ctrlvlts-000/Vintage-Sound-Chip-Player/README.md

# YM2612 Player

A desktop box where a real Yamaha YM2612 sound chip, lit behind a glass window, plays your own music files while you reach into its registers.

See [docs/DESIGN.md](docs/DESIGN.md) for the design.
