ctrlvlts-000/Vintage-Sound-Chip-Player/hardware/README.md

# YM2612 player hardware (Rev B)

The Rev B board, drawn in KiCad. It follows [docs/DESIGN.md](../docs/DESIGN.md). The goal is a
**PCBWay turnkey prototype**: PCBWay makes the board, buys the parts and solders them on. Joey supplies
the YM2612 and plugs it into the socket.

**Status:** Rev B, the Rev A circuit and part positions re-routed after the Oct 30 peer review (see "Rev B changes").
Checked in KiCad 7 in the cloud: DRC 0 errors, 0 unconnected pads and 0 silkscreen warnings. ERC and a final DRC
still need running in KiCad 10. Not ordered yet: see "Still to do before ordering".

## Rev B changes (peer review, Oct 30)

Same circuit, same part positions (the case and 3D model still fit). What changed on the board:

| Review point | Rev A | Rev B |
| --- | --- | --- |
| Clearances | 0.20 mm tracks and gaps, routed right at the limit; vias 0.6 / 0.3 mm (0.15 mm ring, PCBWay's minimum) | 0.25 mm tracks and gaps; vias 0.7 / 0.3 mm (0.2 mm ring). Only the headphone amp's own 0.5 mm-pitch pins keep 0.2 mm (`HP_amp` net class and `ym2612_player.kicad_dru`) |
| Ground traces | 271 ground track pieces, 917 mm, mostly on top of the ground plane | Ground left to the planes. 20 short pieces (49 mm in all) remain where a pad needs one: chip pins onto U8's exposed pad, and pads in small pieces of plane joined to a via |
| Right angles | 66 corners at 90 degrees, 1 sharper | none in open track (43 cut into two 45 degree bends by `tools/miter.py`); the few left sit inside a pad or via |
| Silkscreen | 0.8 mm labels, 95 DRC warnings, 40 labels on a neighbouring part | 1.0 mm labels with a 0.15 mm stroke, none on a pad, part, other label or edge. 24 labels with no clear spot moved to the assembly (F.Fab) layer. Outlines trimmed where stock footprints drew them through pads (the 12 mm buttons). The Gerbers also cut silkscreen away from every pad |
| Logo | none | `[-] CTRLVLTS [+]` on the front silkscreen, above the buttons |
| Pad sizes | KiCad's standard footprints, IPC-7351B nominal | unchanged: these already include the IPC solder fillet margins |

**Just want to look?** Open [ym2612_player/ym2612_player.pdf](ym2612_player/ym2612_player.pdf). GitHub shows it in the browser.
The parts list is [ym2612_player/bom.csv](ym2612_player/bom.csv).
The board, seen from the top:

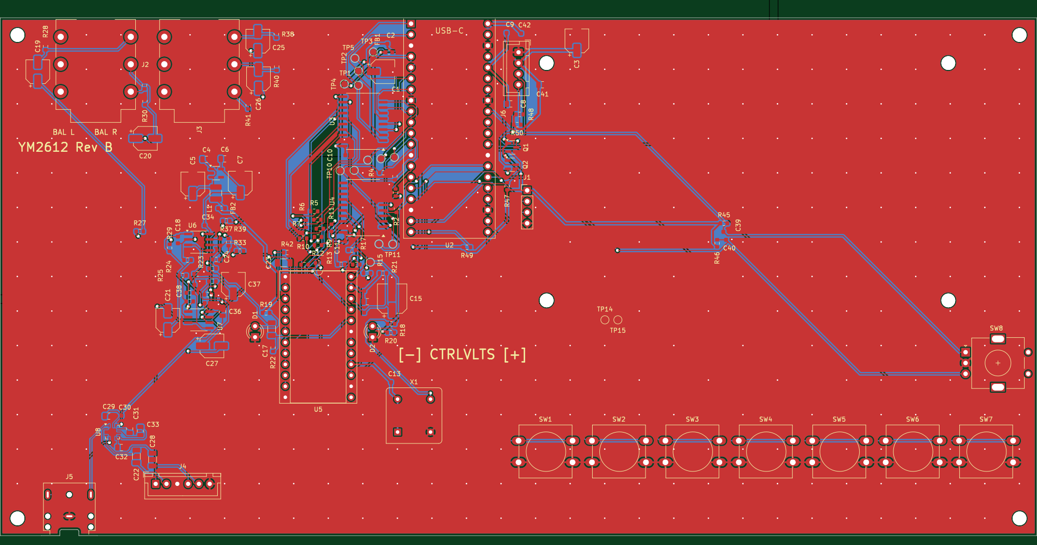
[picture p1: hardware/ym2612_player/board_top.png]
Rev B board, top view


## Opening it in KiCad

1. Install KiCad (any version from 7 up) from <https://www.kicad.org/download/>.
2. Download this repository: on GitHub click the green **Code** button, then **Download ZIP**, and unzip it.
   (While this is still a pull request, pick its branch in the branch menu at the top left first.)
3. In KiCad choose **File > Open Project** and pick `hardware/ym2612_player/ym2612_player.kicad_pro`.
4. Double-click **ym2612_player.kicad_sch**. The first page has one box per page; double-click a box to go in,
   **Alt + Backspace** to come back out.

The files are saved in KiCad 7 format. Newer KiCad opens them and offers to upgrade them the first time you save.
If you'd rather keep working in your own **YM2612 player** project, copy these files into it, or ask Claude to do it
through folder access.

**Reading the drawing:** green lines are wires, drawn part to part (Rev B; Rev A used name tags only). A signal that
goes to another page ends in a name tag (label): tags with the same name are connected, even on different pages. A
small name on a wire is just that wire's name. `+5V`, `+5V_YM`, `+4V5A`, `+3V3` and `GND` are power connections. A
blue X means "not connected on purpose". A part crossed out in red is "do not fit": it has a footprint but PCBWay
leaves it off. The test points on the Controller page still connect by name, like probes.

## Pages

| Page | What's on it |
| --- | --- |
| Power | 5V from the Pico's USB-C, a ferrite-filtered 5V for the chip, and a quiet 4.5V LDO rail for the audio |
| Controller | Pimoroni Pico Plus 2 on two 20-pin sockets, boot-time pull resistors, spare-pin header, test points |
| Sound chip | YM2612 socket, two 74HCT541 buffers (3.3V to 5V) with 100 ohm resistors, clock options, window LEDs |
| Audio out | Model 1 style filter, balanced 1/4" outs, headphone amp with the dual slide volume |
| Front panel | 7 buttons (12 mm), data knob, I2C level shifter, LCD connector |

## The board

240 x 120 mm, 2 layers, rear edge at the top of the picture. Positions below are part centres, measured in mm from
the board's rear-left corner (x to the right, y towards the front). They are what the case needs.

| What | Where |
| --- | --- |
| M3 mounting holes | (4, 4), (236, 4), (4, 116), (236, 116) |
| M3 holes for the LCD standoffs | (126.5, 10.5), (219.5, 10.5), (126.5, 65.5), (219.5, 65.5) |
| Balanced 1/4" outs L / R (rear) | x 30.3 and 54.3, on the rear edge |
| Pico Plus 2 USB-C (rear) | x 104, on the rear edge |
| 3.5 mm headphone jack (front) | x 16, on the front edge |
| Volume slider plug (6-pin JST XH) | (36, 108); the slider itself sits in the case top |
| YM2612 socket / round chip window | window centre (73.6, 74), 44 mm across |
| LCD module (98 x 60 mm, on 15 mm standoffs) | from (124, 8) to (222, 68); its connector J6 just left of it, at about (120, 12) |
| 7 buttons, 12 mm | one row at y 98, from x 120 (Play) to x 222 (Write), 17 mm apart |
| Data knob (encoder) | shaft at (231, 80), below the LCD so the knob clears it |

Ground: one unbroken `GND` plane on both layers, tied together by stitching vias. The audio parts are grouped on the
left, away from USB, the bus and the LCD. (Rev A's first layout split the ground, which put the YM2612's bus over the
audio ground; see the fix register.)

## Ordering from PCBWay (turnkey)

Everything PCBWay asks for is in [ym2612_player/fab](ym2612_player/fab):

- `ym2612_player_gerbers.zip`: the board itself (copper, solder mask, silkscreen, outline, drill holes).
- `ym2612_player_bom.csv`: the parts list. Lines marked "Do not fit" are left off on purpose.
- `ym2612_player_cpl.csv`: where each part goes and which way it turns (the "placement" or "centroid" file).

Upload the zip on PCBWay's PCB Assembly page, choose Turnkey, then add the BOM and CPL when it asks. They check every
part before anything is made and email questions. Nothing is charged until you approve their quote.

## Choices made in this draft

- **Pico Plus 2 on sockets** (Digi-Key PIM724). It has chips and a connector on its underside, so it can't be soldered
  flat. PCBWay solders two 1x20 female sockets to the board (BOM line `U2-SKT`, Sullins PPTC201LFBN-RC, 8.5 mm).
  **Joey supplies the Pico and its two 1x20 male headers** (`U2`, `U2-HDR`, marked "Do not fit"), solders the headers
  and plugs it in, about 9 mm above the board (Joey, Oct 25).
- **YM2612 socket:** Mill-Max turned-pin, 24-pin, 600 mil wide. PCBWay solders the socket only.
- **Clock:** the Pico makes the 7.67 MHz clock (as the design doc proposes). There's an unfitted footprint for a
  7.670454 MHz oscillator can, so switching to exact Genesis pitch is a two-part change with no new board.
- **Buttons:** 12 mm Omron B3F-4055 switches with snap-on round caps (your choice, Oct 24).
- **Analog rail:** LP5907 4.5V low-noise regulator after a ferrite and an LC filter, damped by a 47 µF electrolytic.
- **YM2612 analog supply:** its A.VCC pin (22) has its own 10 ohm + 220 µF + 100 nF filter, so USB noise on the
  chip's 5V doesn't reach its DAC.
- **Decoupling:** every chip has its capacitors within a few mm of its supply pin.
- **Reset pull-downs:** 4.7k on /IC, A0 and A1, because of RP2350 erratum E9 (10k may not pull a released pin low).
- **Ground:** one solid plane, see above.
- **Audio filter:** 2.2k load, then a 3.39 kHz first-order low-pass (Model 1 style). See DESIGN.md 5.5.
- **Balanced outs:** hot and cold legs from OPA2350s, 100 ohm + 10 µF each, Neutrik NMJ6HCD2 jacks, with a 0 ohm
  ground-lift footprint on each sleeve.
- **Headphones:** TI TPA6132A2 headphone amp on the 4.5V rail, -6 dB gain, no output capacitors (Joey, Oct 25). The
  Pico's GP12 switches it on once the rail has settled, so power-up doesn't pop. Firmware must set GP12 high.

## Still to do before ordering

1. **Case:** Joey designs the enclosure around the positions above (Oct 25). Check heights too: the LCD glass sits
   about 27 to 30 mm up, the buttons with caps about 13 mm, the knob shaft about 20 mm.
2. **KiCad 10:** open the project in KiCad 10, run ERC and DRC there, then make the PCBWay files from that copy (see
   "Regenerating"). These files were made in KiCad 7 in the cloud.
3. **Encoder lugs:** compare the Bourns PEC11R mounting-lug spacing with the EC11 footprint (11.2 mm).
4. **Pico Plus 2 holes:** `ym2612.pretty/Pimoroni_PicoPlus2_Socketed` uses the standard Pico hole pattern
   (2.54 mm pitch, rows 17.78 mm apart), which Pimoroni keeps. A quick check with a real board and sockets is cheap.

Window LEDs are Lumimax LED3WAW (3 mm, warm white 2800K, Digi-Key); any 3 mm warm white will do. Add an order note
asking PCBWay not to trim their leads.

Not on the BOM (Joey buys these): Pico Plus 2 and headers, the YM2612, button caps, the encoder knob, the LCD module,
the volume slider and its cable.

## Regenerating

`tools/build.sh` rebuilds the schematic from `tools/design.py` (`tools/wires.py` draws the wires), checks every connection against the netlist, and
re-exports the PDF and BOM (needs KiCad installed). Once anyone edits the schematic in KiCad, the KiCad files become
the real source and the script should not be rerun.

Rev B: `tools/pcb_revb.sh` lists the steps that turned the Rev A placement into this layout (rules, Freerouting
without GND, ground vias and stitching, 45 degree corners, silkscreen, fab files).

`tools/layout.py` places the parts on the board (decoupling capacitors go to the pin named in `design.NEAR`),
`tools/route.py` routes it with Freerouting, `tools/stitch.py` adds the ground stitching vias, `tools/silk.py` moves
the part labels clear of pads and each other, and `tools/fab.sh` makes the PCBWay files. The same rule applies: once the board has been edited in KiCad, edit it there.
