ctrlvlts-000/Vintage-Sound-Chip-Player/docs/DESIGN.md

# YM2612 Player — Rev A Design

Status: Draft v1.1 · Oct 24, 2026 · Concept stage: the chassis is conceptual, and specs may still change · Owner: Joey

> A small box with a real Sega Genesis sound chip, the Yamaha YM2612. Put VGM files
> onto it over USB-C like a thumb drive, pick a song with the buttons, and hear the
> real chip play it through headphones or balanced outputs into your studio.

**Who it's for:** retro computer enthusiasts and synth heads, roughly 40–60, who want to hear
and play with the real silicon from their childhood. Real vintage chips only, no emulation.
The YM2612 is the first of a planned series of classic chiptune chips.

**Rev A is the simplest, lowest-cost version that plays music.** It does VGM import and
playback and nothing else. The lights, synth knobs, fuller transport, and lit window
designed earlier are parked in [LATER-REVISIONS.md](LATER-REVISIONS.md) for Rev B and on.

The Rev A schematic is in [hardware/ym2612_player](../hardware/ym2612_player) (KiCad), aimed at a PCBWay
turnkey prototype. Joey also has a local KiCad project called **YM2612 player**. This
doc is the reference for what goes on that board. Items marked **Proposal** are
recommendations waiting for Joey's OK; items marked **Open** still need a call.

---

## 1. What Rev A does

**Features (the whole list)**

1. **VGM import over USB-C:** plug the player into a computer and it shows up as a USB drive. Drag `.vgm` and `.vgz` files onto it. No memory card.
2. **Playback** on a real YM2612.
3. **Audio outputs:** a 3.5 mm headphone jack, plus **two balanced 1/4" TRS line outs** (L and R) for an audio interface. Target: **noise floor at or below −70 dB** (§5.5).
4. **A 90s character LCD:** a 20 × 4 blue LCD (white characters on blue). It always shows the VGM file that's playing, plus the name of whatever you're editing (§2.1).
5. **A late-80s digital synth front panel:** one data knob and 7 buttons (Play, Stop, ◀, ▶, Edit, Exit, Write) driving simple menus for every function (§2.2–2.4).
6. **Full sound editing:** every YM2612 sound parameter, plus Korg DS-8 style quick controls, reachable from the menus (§2.4).
7. **Lit chip window:** the YM2612 sits under a window in the panel, lit by two warm-white LEDs (§5.7).
8. **USB MIDI in** over the same USB-C cable, with two modes: **VGM mode** plays song files, **MIDI mode** plays the YM2612 like a synth from Ableton or any DAW (§2.5). Costs no extra parts.

**Not in Rev A**

- Register lights, the 4-knob panel, fancier window lighting (see [LATER-REVISIONS.md](LATER-REVISIONS.md)).
- Seek, loop, A-B repeat.
- Genesis PSG parts: only the YM2612 plays (decided Oct 23).
- DIN or TRS MIDI jacks (USB MIDI only), MIDI out, MIDI control of knobs.
- Other chips, battery, wireless.

## 2. Front panel, screen, and menus

The panel works like a late-80s / early-90s digital synth (think Korg M1, Roland D-50, Yamaha
DX7): **one data knob, a few buttons, and a small screen with simple menus**. Nothing is
buried more than one level deep, and the screen always says what you're editing.

### 2.1 The screen: a 90s blue character LCD

**Decision (Joey, Oct 24):** a **20 × 4 character LCD, white characters on blue** (STN
negative, blue backlight): the **HiLetgo HD44780 2004A** with an I²C backpack (PCF8574 type).
Character LCD only, no graphic, OLED, or TFT displays, even vintage-looking ones.

- **Text only:** 4 lines of 20 characters, plus 8 custom characters, used for level bars, ▶ / ■, and a ♪.
- **Paging:** 20 columns means each page shows one or two parameters with their full names, and ◀ / ▶ step through the rest.
- **Contrast** is set once with the trimpot on the backpack.

Alternatives considered and not chosen: 16 × 2 (too small for editing), 40 × 4 (harder wiring),
128 × 64 ST7920 graphic (not a pure character LCD).

**Home screen (VGM mode)** — the playing file is always on the top line:

```
┌────────────────────┐
│GHZ.VGM     ▶ 01:24│  file name, play state, time
│Green Hill Zone     │  title from the GD3 tag
│Sonic the Hedgehog  │  game
│03/27 ▮▮▮▮▮▮▮▮▮ VGM │  track number, 6 channels + DAC activity bars, mode
└────────────────────┘
```

**Edit page** — the file stays on top, the parameter name is spelled out:

```
┌────────────────────┐
│GHZ.VGM     ▶ 01:24│
│OPERATOR CH2        │  page and channel
│ATTACK RATE         │  parameter name
│ 31 [18] 31  28     │  OP1–OP4, cursor on OP2; knob changes it
└────────────────────┘
```

### 2.2 Controls

| Control | On the home screen | In the menus |
| --- | --- | --- |
| **Data knob** | Scroll the track list | Change the value under the cursor, or pick a menu item |
| **◀ / ▶** | Previous / next track | Move the cursor between parameters (and across OP1–OP4) |
| **Play** | Play / pause | Play / pause (you hear edits live) |
| **Stop** | Stop | Stop |
| **Edit** | Open the main menu | Enter the selected menu item |
| **Exit** | — | Back up one level; cancels a prompt |
| **Write** | — | Save (instrument, or your edits to a song), with an "are you sure" prompt |

That's **7 buttons and 1 knob**. The data knob is turn-only. The knob speeds up when spun
fast, so long ranges like operator level (0–127) are quick to cover.

### 2.3 Menu map

Press **Edit** on the home screen to get the main menu. Pick a page with the knob, Edit to
enter it, Exit to come back.

```
MAIN MENU
 1 QUICK EDIT    Channel, Timbre, Timbre EG, Amp EG, Pitch      (Korg DS-8 style)
 2 OPERATOR      10 settings × OP1–OP4, shown side by side
 3 CHANNEL       Algorithm, Feedback, Pan, LFO depth (AM / PM)
 4 LFO           On/off, Speed (all channels)
 5 MODE          VGM player  /  MIDI synth
 6 INSTRUMENT    Load, Init, Rename  (Write saves)
 7 SYSTEM        MIDI channel, Backlight on/off, Loop count, Firmware info
```

Every page shows the **channel** being edited (CH1–CH6 or ALL). On the Quick Edit page,
"Channel" is the first item, and every other page follows it.

### 2.4 What can be edited

| Page | Parameter | Range |
| --- | --- | --- |
| Quick Edit | Channel | All, 1–6 (each remembers its own edits) |
| | Timbre | −10 … +10 (modulator levels: dull to bright) |
| | Timbre EG | −10 … +10 (modulator attack + release) |
| | Amp EG | −10 … +10 (carrier attack + release: snappy to swelling) |
| | Pitch | −12 … +12 semitones |
| Operator (×4) | Attack rate, Decay rate, Sustain rate | 0–31 |
| | Release rate, Sustain level | 0–15 |
| | Level | 0–127 |
| | Multiple (harmonic) | 0–15 |
| | Detune | −3 … +3 |
| | Key scaling | 0–3 |
| | Amplitude mod | off, on |
| | SSG-EG shape | off, 8 shapes |
| Channel | Algorithm | 1–8 (the screen draws the operator wiring) |
| | Feedback | 0–7 |
| | Pan | L, C, R |
| | LFO amplitude depth, pitch depth | 0–3, 0–7 |
| LFO | On/off, Speed | off/on, 0–7 |

That covers every sound setting the YM2612 has.

**What an edit means in each mode**

- **VGM mode:** an edited parameter is **held at your value** on that channel, ignoring what the
  song writes to it; untouched parameters keep following the song. Quick Edit values are offsets
  that bend the song's own values instead. **Write** saves your edits next to the song
  (`GHZ.EDT`), so they come back next time it plays. Holding **Exit** for 2 seconds clears all edits.
- **MIDI mode:** edits change the instrument you're playing. **Write** saves it to the drive as a
  `.tfi` file, after you name it with the knob and ◀ / ▶.

### 2.5 MIDI mode

1. Connect the player to a computer. It's a class-compliant USB MIDI device, so it needs no
   drivers on Windows or macOS and shows up in Ableton Live's MIDI preferences as **YM2612**,
   alongside the USB drive. Turn on **Track** for it, then set a MIDI track's *MIDI To* to
   YM2612, channel 1 (the channel is changeable in System).
2. Notes play the YM2612 with **6-note polyphony** (one note per FM channel; when a 7th note
   arrives, the oldest note is stolen).
3. Switch modes in **MODE**. On the home screen in MIDI mode, the knob picks the instrument.

**Where the instruments come from** :

- **Built-in presets:** a small bank of classic Genesis-style sounds stored with the firmware.
- **Borrowed from songs:** the player scans the VGM files on the drive and lists every
  distinct instrument it finds, named by song and channel, for example *Green Hill Zone · ch 2*.
- **Instrument files:** `.tfi` files (a common 42-byte YM2612 instrument format) dragged onto the drive show up too.

**What MIDI controls in Rev A:**

| MIDI message | Effect |
| --- | --- |
| Note on / off | Plays and releases notes |
| Velocity | Note loudness (carrier operator levels) |
| Pitch bend | ±2 semitones |
| Sustain pedal (CC 64) | Holds notes |
| Program change | Picks the instrument |
| All notes off (CC 123) | Silences the chip |

```
┌────────────────────┐
│MIDI SYNTH  CH1  3/6│  mode, MIDI channel, notes sounding
│014 Green Hill Zone │  instrument number and name
│ ch2  ALG4 FB5      │  where it came from, quick look at the patch
│▮▮▮   voices        │  which of the 6 voices are playing
└────────────────────┘
```

### 2.6 Adding songs

Plug the player into a computer with USB-C, drag `.vgm` / `.vgz` files onto the **YM2612**
drive, then eject it. The player rescans its files after you eject. Playback is paused while
the computer has the drive mounted; MIDI works either way.

### 2.7 Making your own music for it

Any tool that exports **VGM for the YM2612** (Genesis / Mega Drive) can make files for the
player. Known options (each one's VGM export gets tested on the player in M2 before it's
promised to users):

| Tool | What it is | Notes |
| --- | --- | --- |
| **Furnace Tracker** | Free, open-source tracker | YM2612 support, FM operator editor, VGM export |
| **DefleMask** | Paid tracker | Genesis and many other chips, VGM export |
| **MD Synth DAW** | MIT-licensed DAW | Piano roll plus register-track mode; VGM/VGZ and XGM export (XGM isn't played by Rev A) |
| **VGMM, FMDrive VST** | Instrument / patch tools | Make `.tfi` patches, which MIDI mode loads directly (§2.5) |

### 2.8 Chassis look: a 16-bit console homage

**Concept (Joey, Oct 24), open to change:** the chassis pays homage to the original Sega Mega Drive
(first model), using its shapes and colours but **no Sega logos or wordmarks**. Joey designs
and 3D prints it. Concept: [Rev A panel concept](https://claude.ai/artifact/8sheBY3bZY6DmseLGqauJz).

- **Black body,** matte top, with a raised **round disc** where the cartridge slot was. The chip window sits inside the disc, ringed by stepped **concentric rings**.
- **Gold italic lettering** with only our own names (YM2612, 6-CH FM). The product is simply called **YM2612** (Joey, Oct 24).
- **Red accents:** volume slider, power LED, Play button, and the data knob's pointer.
- **Front-left phones jack and volume slider,** where the first model had them.
- A **ribbed strip** along the front edge, after the original's vent ribs.
- The LCD, data knob, and pill-shaped buttons sit to the right of the disc. USB-C and the two balanced outs are on the back.

## 3. The chip: YM2612 at a glance

| Fact | What Rev A does about it |
| --- | --- |
| 6 FM channels with 4 operators each; channel 6 can play 8-bit samples (DAC) | Firmware plays all of it, including drum and voice samples |
| Two register banks, selected with address lines A0 and A1 | 2 GPIO lines |
| 24-pin DIP, 5V, NMOS | DIP socket; 3.3V → 5V buffers between the Pico and the chip |
| Clock about 7.67 MHz (NTSC Genesis) | Generated by the Pico, no oscillator part needed (§5.3) |
| Registers are write-only; the status byte can be read | Rev A never reads it. /RD is tied high, so the bus is one-way |
| Needs a short wait after each write | Fixed minimum gap, measured on a logic analyzer in M1 |
| Analog outputs MOL / MOR | Low-noise filter stage, then headphone and balanced drivers (§5.5) |

## 4. How it works

### 4.1 Audio pipeline

```mermaid
flowchart LR
    PC[Computer<br/>drag and drop]

    subgraph PICO["Pimoroni Pico Plus 2 (RP2350)"]
        USB[USB drive<br/>over USB-C]
        FLASH[(16 MB flash<br/>VGM / VGZ files)]
        PARSE[VGM parser]
        PCM[(Sample data<br/>in PSRAM)]
        SCHED[Write scheduler<br/>44.1 kHz timeline]
        DRV[YM2612 driver<br/>PIO bus writes]
        CLKGEN[Clock output<br/>7.67 MHz]
        UI[Display, buttons,<br/>data knob]
        SYN[Edit engine<br/>all sound settings]
    end

    BUF[74HCT buffers<br/>3.3V to 5V]
    YM{{YM2612}}
    FILT[Model 1-style filter<br/>OPA2350]
    AMP[TPA6132A2<br/>headphone amp]
    JACK((3.5 mm<br/>headphones))
    BAL[Balanced driver<br/>OPA2350]
    TRS((2x 1/4 in TRS<br/>balanced L / R))
    LCD[20x4 blue<br/>character LCD]
    BTN[Data knob +<br/>7 buttons]
    MIDI[USB MIDI<br/>keyboard / DAW]

    PC --> USB --> FLASH --> PARSE
    PARSE -- "sample data" --> PCM
    PARSE -- "timed writes" --> SCHED
    PCM -- "DAC bytes" --> SCHED
    SCHED --> SYN --> DRV --> BUF --> YM
    UI -- "edits" --> SYN
    CLKGEN --> BUF
    YM -- "analog L/R" --> FILT
    FILT --> AMP --> JACK
    FILT --> BAL --> TRS
    BTN --> UI
    UI --> LCD
    UI -- "start, stop" --> SCHED
    MIDI -- "notes (MIDI mode)" --> SYN
```

In plain words: the Pico reads a VGM file from its own flash memory, where you copied it over USB. The file is a list of "write
this value to this chip setting, then wait this long". One of the Pico's two cores
plays those writes to the YM2612 at the right moments. The other core runs the display
and buttons. The YM2612 makes the sound, and the op-amps clean it up and drive
the headphone jack and the balanced outputs.

### 4.2 Firmware modules

| Module | Job |
| --- | --- |
| **Storage** | A FAT filesystem in the board's flash (about 14 MB free after the firmware), read with FatFs. Builds the track list. |
| **USB** | TinyUSB composite device: a mass-storage drive labelled YM2612 plus a USB MIDI device called YM2612. While the computer has the drive mounted, VGM playback is off; after eject, the player rescans the files. MIDI works either way. |
| **MIDI mode** | Voice allocator for 6 notes, note/velocity/pitch-bend/sustain handling, and an instrument library (presets, `.tfi` files, and instruments extracted from VGM files by watching which register sets each song writes). Writes go through the same YM2612 driver. |
| **VGM parser** | Reads the header (clock, length, loop point) and GD3 tags (title, game). Turns commands into timed writes: YM2612 port 0/1 writes, waits, PCM data blocks, DAC writes, and DAC stream commands. Skips PSG writes. VGZ files are unzipped while loading, which matters more now since storage is limited. |
| **Sample data** | Loads the song's PCM samples into the board's 8 MB PSRAM, so even sample-heavy tracks fit. |
| **Scheduler** | Runs on core 1. Releases each write at its exact sample time (1/44,100 s). Stops at the end, or after the loop has played twice. |
| **YM2612 driver** | PIO program: put A1/A0 and D0–D7 on the pins, pulse /WR, wait the minimum gap. Also pulses /IC (reset) at power-up and on Stop to silence the chip. |
| **Edit engine** | Keeps every sound parameter per channel. In VGM mode it holds edited parameters at your value (and applies Quick Edit as offsets) on every write; in MIDI mode it edits the current instrument. Saves instruments as `.tfi` and song edits as `.edt`. Clamps settings that would be silent or painful. |
| **UI** | Runs on core 0. Runs the menus: debounces the 7 buttons, reads the data knob (with acceleration), and drives the HD44780 LCD over I²C at 400 kHz, rewriting only characters that changed. Never delays a chip write. |

## 5. Hardware

### 5.1 Block diagram

```
Pico USB-C ── VBUS 5V ──────┬─ ferrite + caps ── YM2612, 74HCT buffers
                           ├─ ferrite + LC filter ── low-noise LDO 4.5V ── op-amps (analog rail)
                           ├─ Pico's own 3.3V regulator ── Pico
                           └─ ferrite ── LCD + backlight (5V, digital side)

Pico GPIO ── 2× 74HCT541 ── YM2612 (DIP socket) ── OPA2350 filter ─┬─ TPA6132A2 ── 3.5 mm headphones
                                                                   └─ OPA2350 inverter ── 2× 1/4" TRS balanced
     ├── I²C ── level shifter ── 20×4 LCD backpack
     └── 7 buttons + data knob to GND
```

### 5.2 Parts (Proposal)

| Part | Choice | Rough cost |
| --- | --- | --- |
| Microcontroller | **Pimoroni Pico Plus 2** (RP2350, 16 MB flash, 8 MB PSRAM, USB-C), Pico-sized, soldered by its castellated edges or on headers | $12–15 |
| Sound chip | YM2612, pulled from a Model 1 Genesis or bought tested | $5–15 |
| Chip socket | 24-pin DIP, turned-pin (Mill-Max 110-43-624-41-001000). PCBWay fits the socket; Joey fits the chip | $2 |
| Level shifting | 2× 74HCT541 (one-way 3.3V → 5V buffers, powered from 5V) | $1 |
| Filter / buffer | OPA2350 low-noise, rail-to-rail dual op-amp rated for 2.7–5.5V (L and R), with Model 1 filter values | $2 |
| Headphone driver | TI TPA6132A2 stereo headphone amp (WQFN-16), runs from the 4.5V rail, ground-centred outputs with no output capacitors, enable pin mutes it at power-up (fix register F5, Oct 25) | $1.50 |
| Balanced driver | OPA2350 dual op-amp making the inverted (cold) leg for L and R | $2 |
| Analog supply | LP5907MFX-4.5 low-noise 4.5V LDO plus ferrite and 10 µH / 22 µF filter, damped by a 47 µF electrolytic | $1 |
| Audio jacks | 3.5 mm stereo headphone jack (front) + 2× 1/4" TRS panel jacks (rear) | $3–4 |
| Headphone volume | Dual-gang slide potentiometer with a red cap, before the headphone driver only | $1–2 |
| Display | HiLetgo HD44780 2004A 20×4 LCD, blue backlight, with I²C backpack (PCF8574 type), 5V | $10–13 |
| I²C level shifter | 2-channel bidirectional (BSS138 MOSFETs or a PCA9306), 3.3V ↔ 5V | $0.50 |
| Buttons | 7× 12 mm tactile switches (Omron B3F-4055) with snap-on round caps, red for Play (Joey, Oct 24) | $4 |
| Data knob | Rotary encoder, no push switch needed (EC11 type), with a knob cap | $1 |
| Power and file loading | The Pico board's own USB-C port (no extra connector) | $0 |
| Chip window light | 2× warm-white 3 mm LEDs with resistors, on 5V, always on | $0.20 |
| Passives | Decoupling, ferrites, op-amp resistors and caps, output caps | $2 |
| PCB | 2-layer, about 100 × 70 mm | about $1 each in a batch of 5 |

**Rough total: $40–50 per board** before the enclosure, mostly depending on the YM2612's price.

### 5.3 Cost savers in this design

- **No crystal oscillator for the chip.** The RP2350 runs at 153.33 MHz (12 MHz × 115 ÷ 9),
  and its clock-output pin divides that by 20 to give **7.667 MHz**, within 0.05% of
  a real Genesis (less than 1 cent of pitch). The clock goes through a spare 74HCT541
  channel to reach 5V levels. **Proposal:** add an unpopulated footprint for an oscillator
  can as a fallback.
- **No busy-flag reads,** so the buffers only go one way and /RD is tied high.
- **No memory card, USB connector, regulator, or power switch.** The Pico board's USB-C port loads files and powers everything.

### 5.4 Pin map (Proposal)

Consecutive pins keep the PIO program simple. The Pico Plus 2 uses the standard Pico header for GP0–GP28. Check each pin against its pinout in KiCad.

| Pico GPIO | Signal | Goes to |
| --- | --- | --- |
| GP0–GP7 | D0–D7 | 74HCT541 #1 → YM2612 data bus |
| GP8 | A0 | 74HCT541 #2 → YM2612 |
| GP9 | A1 | 74HCT541 #2 → YM2612 |
| GP10 | /WR | 74HCT541 #2 → YM2612 |
| GP11 | /IC (reset) | 74HCT541 #2 → YM2612 |
| GP21 | Clock out (GPOUT0) | 74HCT541 #2 → YM2612 φM |
| GP14 | LCD SDA (I²C1) | level shifter → LCD backpack |
| GP15 | LCD SCL (I²C1) | level shifter → LCD backpack |
| GP12, GP13 | Spare | free for later (for example dimming the window LEDs) |
| GP16 | Button Play | to GND, internal pull-up |
| GP17 | Button Stop | to GND, internal pull-up |
| GP18 | Button ◀ | to GND, internal pull-up |
| GP19 | Button ▶ | to GND, internal pull-up |
| GP20 | Button Edit | to GND, internal pull-up |
| GP22 | Button Exit | to GND, internal pull-up |
| GP26 | Button Write | to GND, internal pull-up |
| GP27 | Data knob A | encoder, internal pull-up |
| GP28 | Data knob B | encoder, internal pull-up |
| — | /CS tied low, /RD tied high | YM2612 |

### 5.5 Audio output and the −70 dB target

**Signal path**

- **Authentic sound only (Joey, Oct 24).** The YM2612's own built-in DAC is the same one the
  console used, so the "Mega Drive DAC" comes for free. After it, the board copies the
  **first-model console's analog output stage**: the same load resistors on MOL/MOR and the
  same low-pass filter that softens the top end. There's no "clean" mode and no switch.
- The filter is built around an **OPA2350** buffer, with the resistor and capacitor values taken
  from a real Model 1 schematic and checked by measuring an original console's output in M4.
  The Rev A schematic starts from published Model 1 style values: a 2.2k load on MOL / MOR (as in
  the Mega Amp), then a first-order low-pass at 3.39 kHz (47k in, 100k ‖ 470 pF feedback, the same
  corner as the 47k / 1 nF Model 1 filter). One capacitor swap (560 pF) moves it to 2.84 kHz if the
  M4 comparison says so.
- No USB audio: like the original hardware, the sound only leaves through the analog jacks.
- From there, each channel splits two ways:
  - **Headphones:** a TPA6132A2 headphone amp drives the 3.5 mm jack directly (its outputs sit at 0 V, so no
    output capacitors). It runs at -6 dB gain, so the filter's full output fits its swing, and the Pico keeps it
    switched off until the audio rail has settled, which stops the power-on pop.
  - **Balanced line out:** the filter output is the *hot* leg, and a second OPA2350 makes an
    inverted *cold* leg. Both go through 100 Ω resistors and DC-blocking capacitors to a 1/4"
    TRS jack (tip = hot, ring = cold, sleeve = ground). A 5V board can only swing about 3 V
    per leg, but balanced doubles that between hot and cold, so the line out reaches about
    2 V RMS.

**Why balanced:** in the studio, the player is on USB to the PC and its audio goes into an
audio interface on the same PC. That creates a ground loop, the usual cause of hum and USB
whine. A balanced input on the interface rejects noise that appears equally on hot and cold,
so the loop stops mattering.

**Target:** idle noise floor **at or below −70 dB relative to full-scale output**, 20 Hz–20 kHz,
measured on the balanced outs into an audio interface with the player on USB to the same PC.
That level of hiss is easy for these op-amps. The work is keeping digital noise out:

- **Analog rail:** USB 5V → ferrite → LC filter → low-noise LDO (about 4.5V) for the op-amps
  only. The 2.25V mid-rail reference gets its own RC filter and a large capacitor.
- **Grounds:** a solid analog ground area under the audio section, joined to digital ground at
  one point. USB, the bus, and the clock never cross the analog area.
- **The chip:** the YM2612's own supply gets its own ferrite and decoupling, and its outputs
  leave on short traces straight into the analog section.
- **Spare footprints:** room for an extra filter stage and a ground-lift resistor, in case
  measurements in M4 call for them.

While music plays, the YM2612's own 9-bit DAC adds its well-known grit. That's the chip's
character, not noise from the board, and it isn't part of the −70 dB figure.

### 5.6 Protecting the chip

- Series resistors (about 100 Ω) on every buffer output into the YM2612.
- The YM2612 is socketed and only gets 5V through a ferrite and decoupling right at its pins.
- Keep a spare YM2612 on hand. Buy from a seller with returns, since pulled and fake chips are common.
- **Sourcing plan (open):** real YM2612s come from used Model 1 Genesis consoles or resellers. Test every chip on the M1 breadboard rig before it goes in a box.

### 5.7 Chip window light

Two warm-white 3 mm LEDs on the board, angled across the top of the socketed YM2612 so the
chip's markings catch the light through the panel window (a black package won't glow from
behind). They run from 5V through resistors, always on, at about 5 mA each, on the digital
side of the board. Joey's enclosure provides the window. Brighter or music-reactive lighting
is parked for later revisions.

### 5.8 Why a Raspberry Pi Pico

- **PIO:** the RP2350's PIO state machines make the chip's clock and drive the bus and write strobes with exact timing, without using CPU time.
- **Enough GPIO** for the chip bus, display, data knob, and buttons; low cost, so one per box is practical.
- **Language:** C/C++ with the Pico SDK for the timing-critical parts.
- **Runner-up:** Teensy 4.1 (faster, built-in SD slot, costs more).
- **Rejected:** a full Raspberry Pi running Linux (no guaranteed real-time timing, slow to boot); STM32 (capable, but more toolchain effort for the same result).

## 6. KiCad notes for Joey's "YM2612 player" project

- Symbols you may need to make: YM2612 (DIP-24). The LCD connects through a 4-pin header (5V, GND, SDA, SCL) to its I²C backpack.
- The backpack's I²C address is usually **0x27**, sometimes **0x3F**; firmware scans for it.
- The backlight draws real current (tens of mA), so feed the LCD from the 5V rail, not the Pico's 3.3V. The backpack's jumper can cut the backlight if needed.
  The Pico Plus 2 uses the standard Pico footprint (Raspberry Pi's official KiCad footprint works).
- Put the YM2612, buffers, and op-amps on the 5V side of the board, and the display connector on the 3.3V side. Keep the LCD cable and its backlight current away from the audio corner.
- Keep the 7.67 MHz clock trace short, and away from the audio traces.
- Place the headphone jack and volume slider on the front-left edge, and both 1/4" TRS jacks and the Pico board's USB-C port on the rear edge, so the case can expose them.
- Keep the analog section (op-amps, LDO, jacks) in one corner, away from the Pico, bus, and clock.
- Add test points for D0–D7, A0, A1, /WR, and the clock for the logic analyzer in M1.

## 7. Milestones

| # | Milestone | Done when |
| --- | --- | --- |
| M0 | **Parts in hand** | Tested-good YM2612 (plus a spare), Pico Plus 2, buffers, op-amps, display |
| M1 | **First sound** | Breadboard: the Pico clocks the YM2612 and plays a hard-coded FM note; write gap measured |
| M2 | **Play a VGM** | Files dragged on over USB-C appear on the drive, and a Genesis VGM plays start to finish, samples included; VGM exports from Furnace and DefleMask play correctly |
| M3 | **Screen + panel** | 20×4 LCD home screen with file name and time; data knob, ◀ ▶, Play, Stop working |
| M3a | **Menus + editing** | Every menu page works; edits are heard live on a playing song and in MIDI mode; Write saves `.edt` and `.tfi` files |
| M3b | **MIDI mode** | A USB keyboard or DAW plays 6-note chords on the YM2612 using built-in and borrowed instruments |
| M4 | **Authentic, quiet audio** | Filter matches the Model 1 output stage (A/B against a real console); idle noise floor at or below −70 dB on the balanced outs into an interface on the same PC; no hum or whine on headphones |
| M5 | **Schematic + PCB** | Joey's KiCad project matches this doc; boards ordered |
| M6 | **Rev A built** | Assembled board loads files over USB-C and plays them in a simple case |

## 8. Open questions

- [x] **Headphone volume:** a front slide pot on the headphone output only, part of the console homage (Oct 24). The balanced outs stay at a fixed line level.
- [x] **Display:** HiLetgo 20×4 blue character LCD on I²C, from the Chip Box spec (Joey, Oct 24). USB-C loading and USB MIDI stay.
- [x] **Buttons:** 12 mm tactile switches with snap-on caps, for a synth feel (Joey, Oct 24).
- [ ] **Clock:** Pico-generated clock (proposed), or an oscillator can for exact Genesis pitch? The Rev A schematic does the Pico clock and has an unfitted oscillator footprint, so either works on the same board.
- [x] **File loading:** over USB-C into the board's flash, no microSD (Joey, Oct 24).
- [ ] **VGZ:** proposed as required in Rev A, since zipped files stretch the 16 MB of storage.

## 9. Glossary

- **VGM / VGZ:** "Video Game Music", a recording of every chip write a game made, with timing. VGZ is the zipped version.
- **GD3 tag:** the part of a VGM file that holds the track title, game, and composer.
- **Register:** a tiny memory slot in the chip; writing a number to it changes pitch, volume, or tone.
- **PIO:** programmable I/O blocks on the RP2350 that toggle pins with exact timing.
- **DAC:** the YM2612's sample-playback mode on channel 6, used for drums and voices.
- **PSG:** the Genesis's second, simpler sound chip. Rev A doesn't play its parts.
- **Level shifting:** converting the Pico's 3.3V signals to the 5V the YM2612 expects.
