ctrlvlts-000/Vintage-Sound-Chip-Player/hardware/ym2612_player/bom.csv

Designator | Qty | Value | Manufacturer | Manufacturer Part Number | Description | Package / Footprint | Type | Fit
C1,C3,C5,C7,C37 | 5 | 47uF | Any | generic | electrolytic, 16V | CP_Elec_5x5.4 | SMD | Fit
C2,C9,C10,C11,C12,C13,C16,C30,C34,C35,C38,C42 | 12 | 100nF | Any | generic | X7R, 16V | C_0603_1608Metric | SMD | Fit
C4 | 1 | 22uF | Any | generic | X5R, 10V, 0805 | C_0805_2012Metric | SMD | Fit
C6 | 1 | 4.7uF | Any | generic | X5R, 10V, 0805 | C_0805_2012Metric | SMD | Fit
C8,C36,C41 | 3 | 10uF | Any | generic | X5R, 10V, 0805 | C_0805_2012Metric | SMD | Fit
C14 | 1 | 10uF | Any | generic | X5R, 16V, 0805 | C_0805_2012Metric | SMD | Fit
C15 | 1 | 220uF | Any | generic | electrolytic, 16V | CP_Elec_6.3x7.7 | SMD | Fit
C17,C23 | 2 | 1uF | Any | generic | X7R, 50V, 1206 | C_1206_3216Metric | SMD | Fit
C18,C24 | 2 | 470pF | Any | generic | C0G, 50V | C_0603_1608Metric | SMD | Fit
C19,C20,C25,C26 | 4 | 10uF | Any | generic | electrolytic, 16V, low-leakage | CP_Elec_5x5.4 | SMD | Fit
C21,C27 | 2 | 10uF | Any | generic | electrolytic, 16V | CP_Elec_5x5.4 | SMD | Fit
C22,C28 | 2 | 1uF | Any | generic | X7R, 25V, 1206 | C_1206_3216Metric | SMD | Fit
C29,C31,C32 | 3 | 2.2uF | Any | generic | X5R, 10V, 0805 | C_0805_2012Metric | SMD | Fit
C33 | 1 | 1uF | Any | generic | X5R, 10V, 0805 (charge-pump flying cap) | C_0805_2012Metric | SMD | Fit
C39,C40 | 2 | 10nF | Any | generic | X7R, 16V | C_0603_1608Metric | SMD | Fit
D1,D2 | 2 | warm white 3 mm | Lumimax | LED3WAW | 3 mm through-hole LED, warm white 2800K, 3.2V. Any 3 mm warm white will do. Order note for PCBWay: do not trim the leads, Joey bends them to aim the light | LED_D3.0mm | THT | Fit
FB1,FB2 | 2 | 220R@100MHz | Murata | BLM18PG221SN1D | ferrite bead, 0603, 1A+ | L_0603_1608Metric | SMD | Fit
J1 | 0 | Spare GPIO (not fitted) | Any | generic |  | PinHeader_1x04_P2.54mm_Vertical | THT | Do not fit
J2,J3 | 2 | 1/4" TRS balanced out L / 1/4" TRS balanced out R | Neutrik | NMJ6HCD2 | Neutrik 1/4in stereo jack, horizontal PCB. The footprint's SN pad is left unconnected. | Jack_6.35mm_Neutrik_NMJ6HCD2_Horizontal | THT | Fit
J4 | 1 | Volume slider (dual 10k audio taper, in the case) | JST | B6B-XH-A(LF)(SN) | JST XH 6-pin header. Wire a dual 10k audio-taper slide pot: L top/wiper/bottom on 1-3, R on 4-6. | JST_XH_B6B-XH-A_1x06_P2.50mm_Vertical | THT | Fit
J5 | 1 | 3.5 mm headphones (front) | CUI Devices / Same Sky | SJ1-3523N | CUI 3.5 mm stereo jack, horizontal | Jack_3.5mm_CUI_SJ1-3523N_Horizontal | THT | Fit
J6 | 1 | LCD (I2C backpack: GND, VCC, SDA, SCL) | JST | B4B-XH-A(LF)(SN) | JST XH 4-pin header | JST_XH_B4B-XH-A_1x04_P2.50mm_Vertical | THT | Fit
L1 | 1 | 10uH | Murata | LQH32CN100K53L | 10uH, 1210, 300mA+ | L_1210_3225Metric | SMD | Fit
Q1,Q2 | 2 | BSS138 | onsemi | BSS138 | N-MOSFET, SOT-23 | SOT-23 | SMD | Fit
R1,R25,R26,R35,R36,R43,R44,R45,R46 | 9 | 10k | Any | generic | 1%, 0603 | R_0603_1608Metric | SMD | Fit
R2,R3,R4,R42,R47,R48,R49,R50 | 8 | 4.7k | Any | generic | 1%, 0603 | R_0603_1608Metric | SMD | Fit
R5,R6,R7,R8,R9,R10,R11,R12,R13,R14,R15,R16,R27,R29,R37,R39 | 16 | 100 | Any | generic | 1%, 0603 | R_0603_1608Metric | SMD | Fit
R17 | 1 | 33 | Any | generic | 1%, 0603 | R_0603_1608Metric | SMD | Fit
R18 | 0 | 33 | Any | generic | 1%, 0603 | R_0603_1608Metric | SMD | Do not fit
R19,R20 | 2 | 430 | Any | generic | 1%, 0603 | R_0603_1608Metric | SMD | Fit
R21 | 1 | 10 | Any | generic | 1%, 0603 (A.VCC filter) | R_0603_1608Metric | SMD | Fit
R22,R32 | 2 | 2.2k | Any | generic | 1%, 0603 | R_0603_1608Metric | SMD | Fit
R23,R33 | 2 | 47k | Any | generic | 1%, 0603 | R_0603_1608Metric | SMD | Fit
R24,R28,R30,R34,R38,R40 | 6 | 100k | Any | generic | 1%, 0603 | R_0603_1608Metric | SMD | Fit
R31,R41 | 2 | 0 | Any | generic | 0 ohm, 0603 (ground lift option) | R_0603_1608Metric | SMD | Fit
SW1,SW2,SW3,SW4,SW5,SW6,SW7 | 7 | Play (red cap) / Stop / Left / Right / Edit / Exit / Write | Omron | B3F-4055 | Omron 12 mm tactile switch, 7.3 mm tall, with a B32-series snap-on round cap | SW_PUSH-12mm | THT | Fit
SW8 | 1 | Data knob | Bourns | PEC11R-4215F-N0024 | Bourns 24-step encoder, no push switch, 15 mm shaft (EC11 footprint) | RotaryEncoder_Alps_EC11E_Vertical_H20mm | THT | Fit
U1 | 1 | LP5907MFX-4.5 | Texas Instruments | LP5907MFX-4.5/NOPB | low-noise LDO, 4.5V, 250mA | SOT-23-5 | SMD | Fit
U2 | 0 | Pimoroni Pico Plus 2 | Pimoroni | PIM724 | Joey supplies the Pico Plus 2 and solders 2x 20-pin male headers to it; it plugs into sockets U2-SKT | Pimoroni_PicoPlus2_Socketed | THT | Do not fit
U3,U4 | 2 | 74HCT541 | Nexperia | 74HCT541D,653 | octal buffer, HCT, SOIC-20 | SOIC-20W_7.5x12.8mm_P1.27mm | SMD | Fit
U5 | 1 | YM2612 (socket only, chip fitted by hand) | Mill-Max | 110-43-624-41-001000 | Mill-Max 24-pin 600 mil turned-pin DIP socket. PCBWay fits the socket only. | DIP-24_W15.24mm_Socket | THT | Fit
U6,U7 | 2 | OPA2350UA | Texas Instruments | OPA2350UA | dual rail-to-rail op-amp, 2.7-5.5V | SOIC-8_3.9x4.9mm_P1.27mm | SMD | Fit
U8 | 1 | TPA6132A2RTER | Texas Instruments | TPA6132A2RTER | TI DirectPath stereo headphone amp, 2.3-5.5V, WQFN-16 3x3 mm (RTE) | WQFN-16-1EP_3x3mm_P0.5mm_EP1.68x1.68mm | SMD | Fit
X1 | 0 | 7.670454 MHz, 5V (not fitted) | Any | generic | half-size DIP-8 oscillator can, 5V CMOS, 7.670454 MHz | Oscillator_DIP-8 | THT | Do not fit
U2-SKT | 2 | 1x20 female socket, 2.54 mm | Sullins | PPTC201LFBN-RC | Soldered to the board in U2's two rows of holes, 8.5 mm tall | 1x20 P2.54mm vertical | THT | Fit
U2-HDR | 0 | 1x20 male header, 2.54 mm | Any | generic | Joey supplies and solders these to the Pico Plus 2 (U2) so it plugs into U2-SKT | 1x20 P2.54mm vertical | THT | Do not fit
