ctrlvlts-000/Vintage-Sound-Chip-Player/hardware/ym2612_player/ym2612_player.pdf

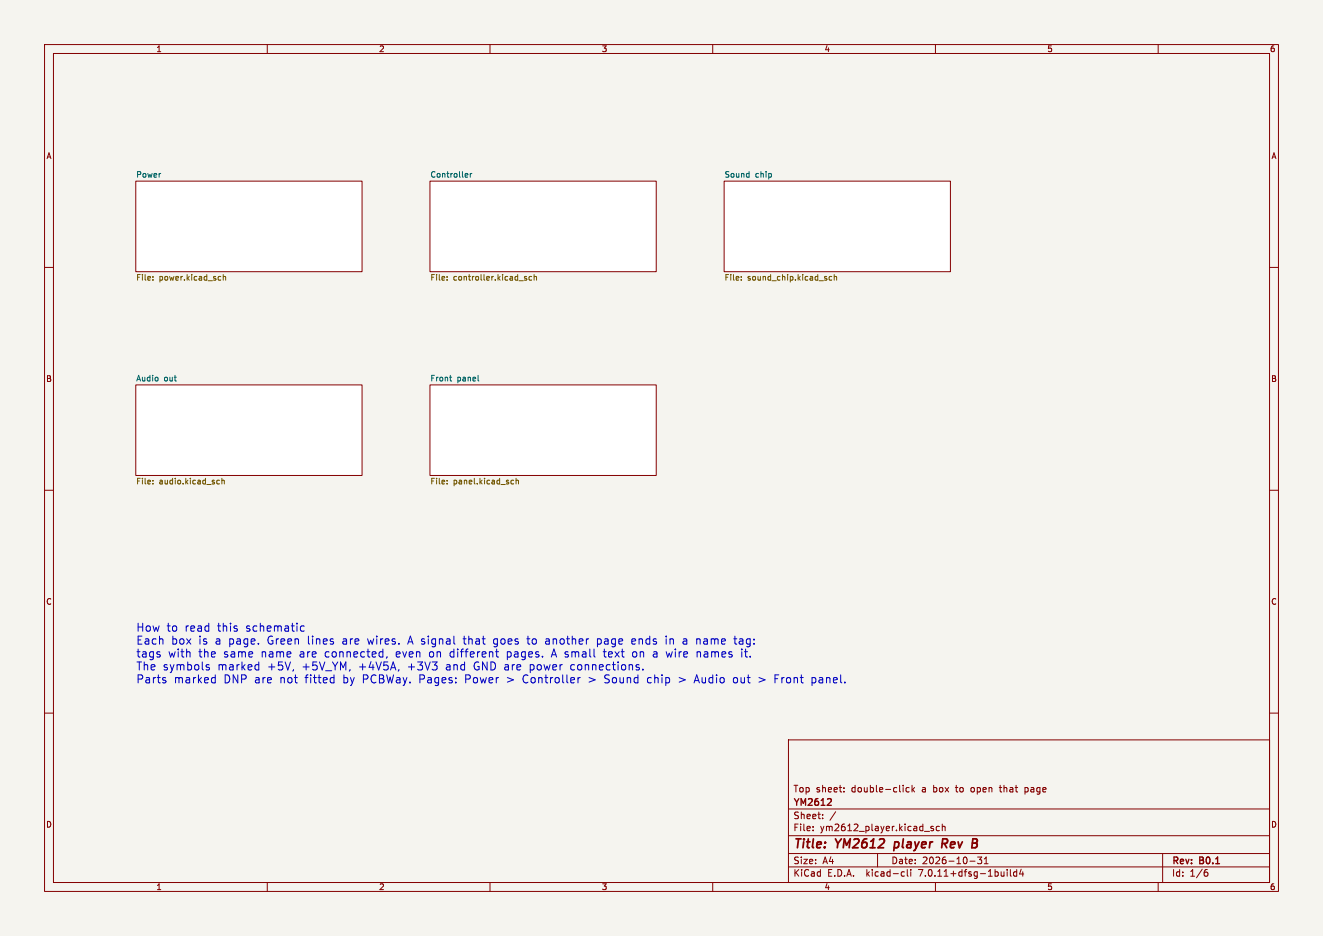
[picture p2: page 1]

Id: 1/6 Title: YM2612 player Rev B

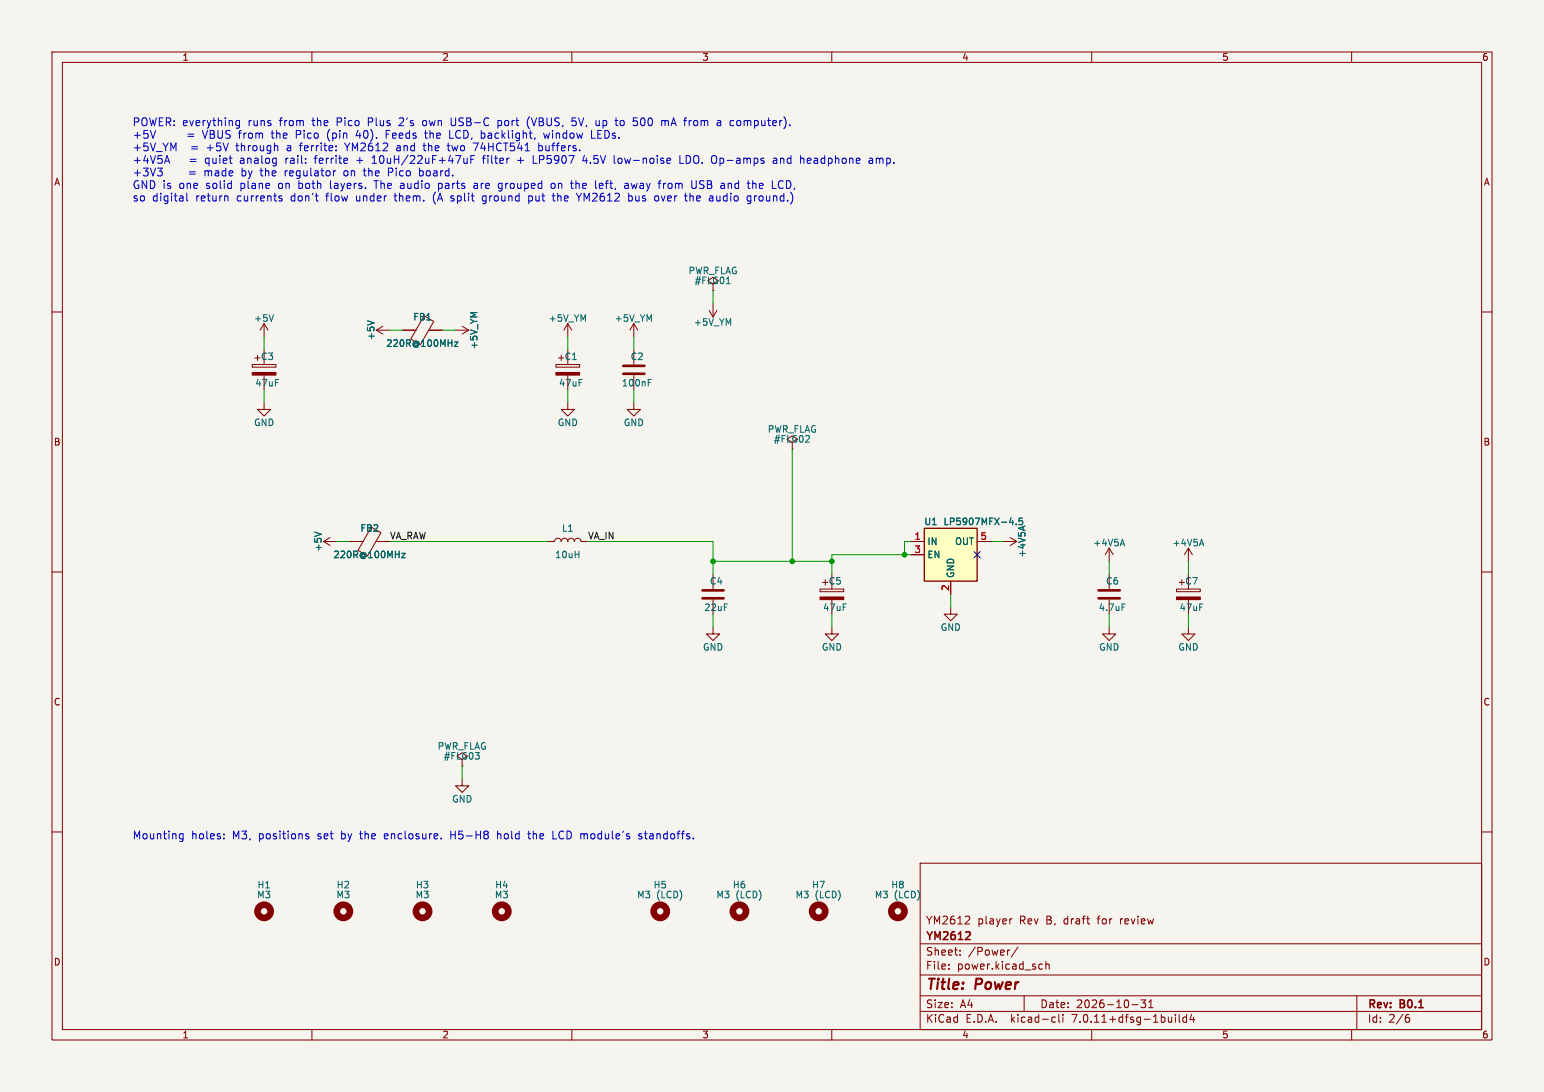
[picture p3: page 2]

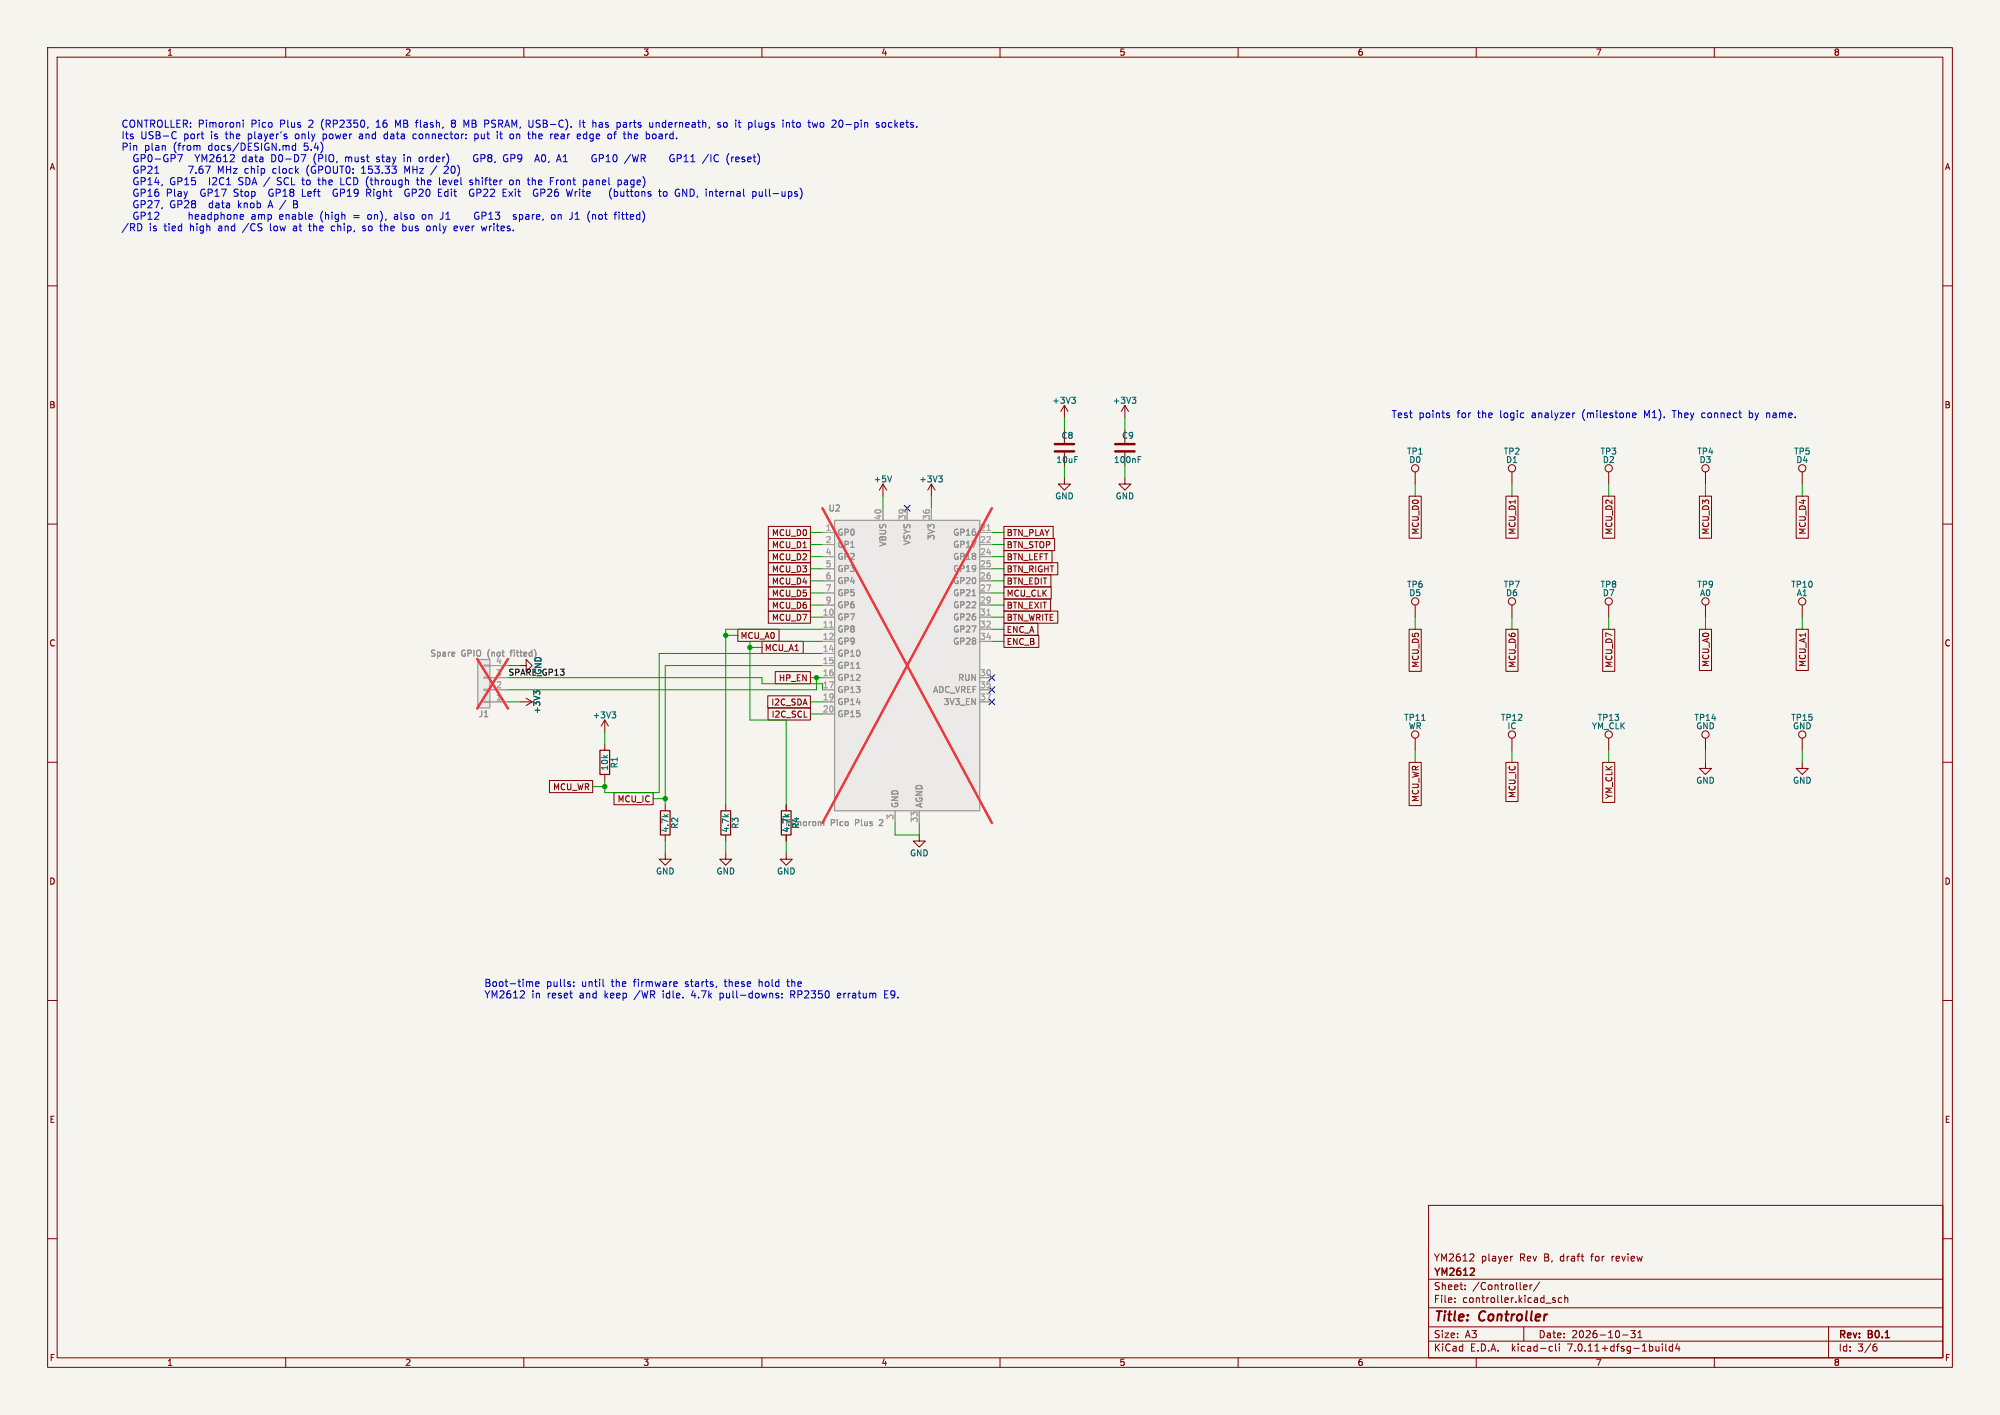
[picture p4: page 3]

J1 Spare GPIO (not fitted) 1

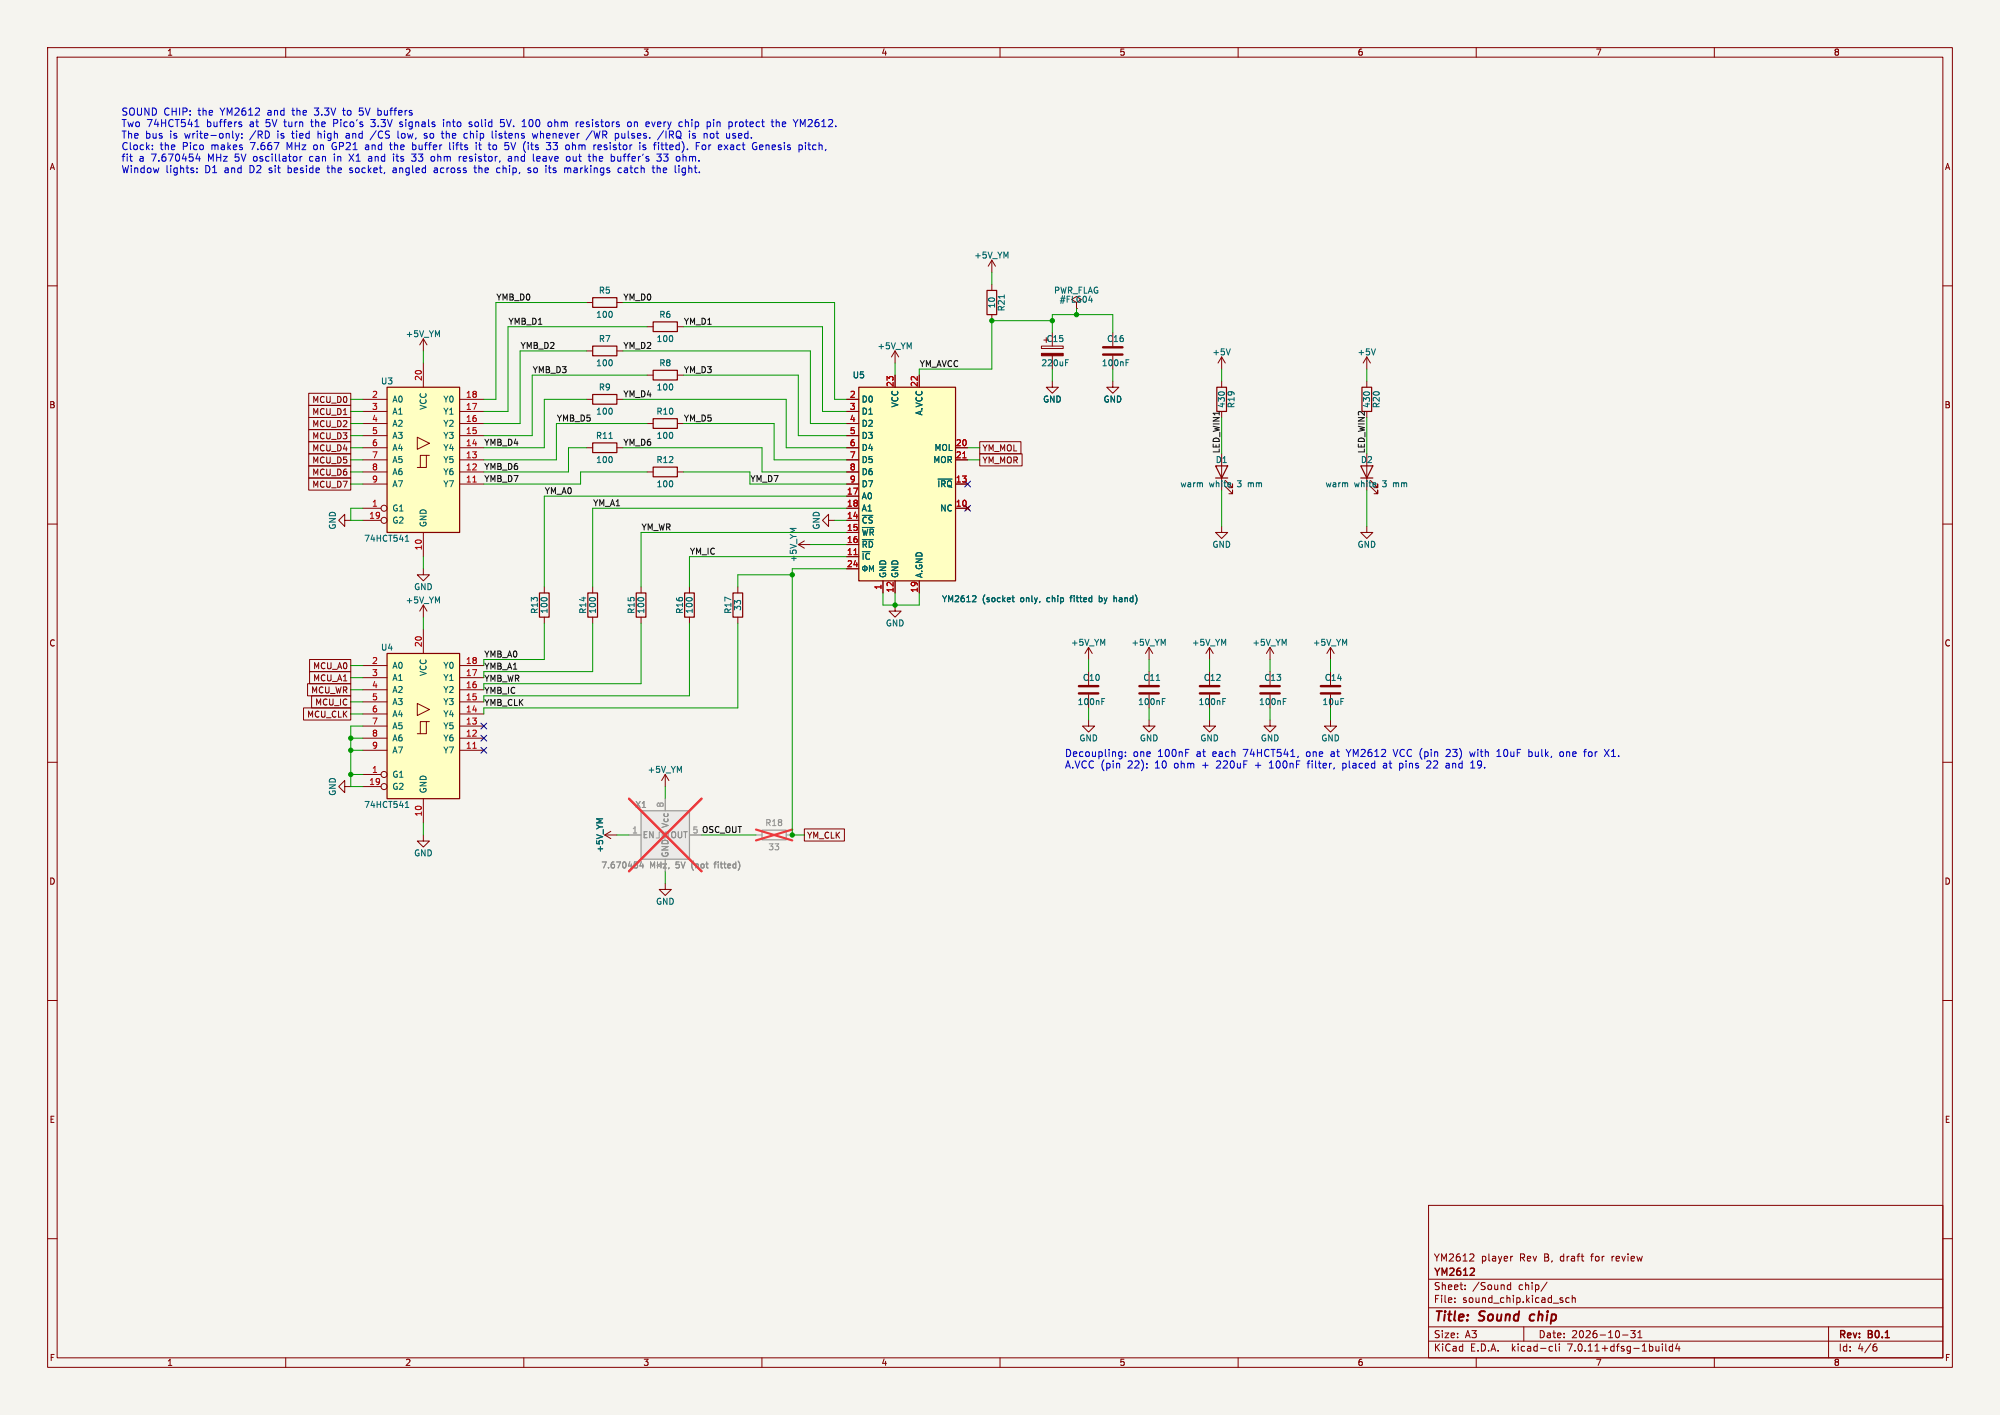
[picture p5: page 4]

4 OUT 5 Vcc 8 GND GND

Id: 4/6 Title: Sound chip

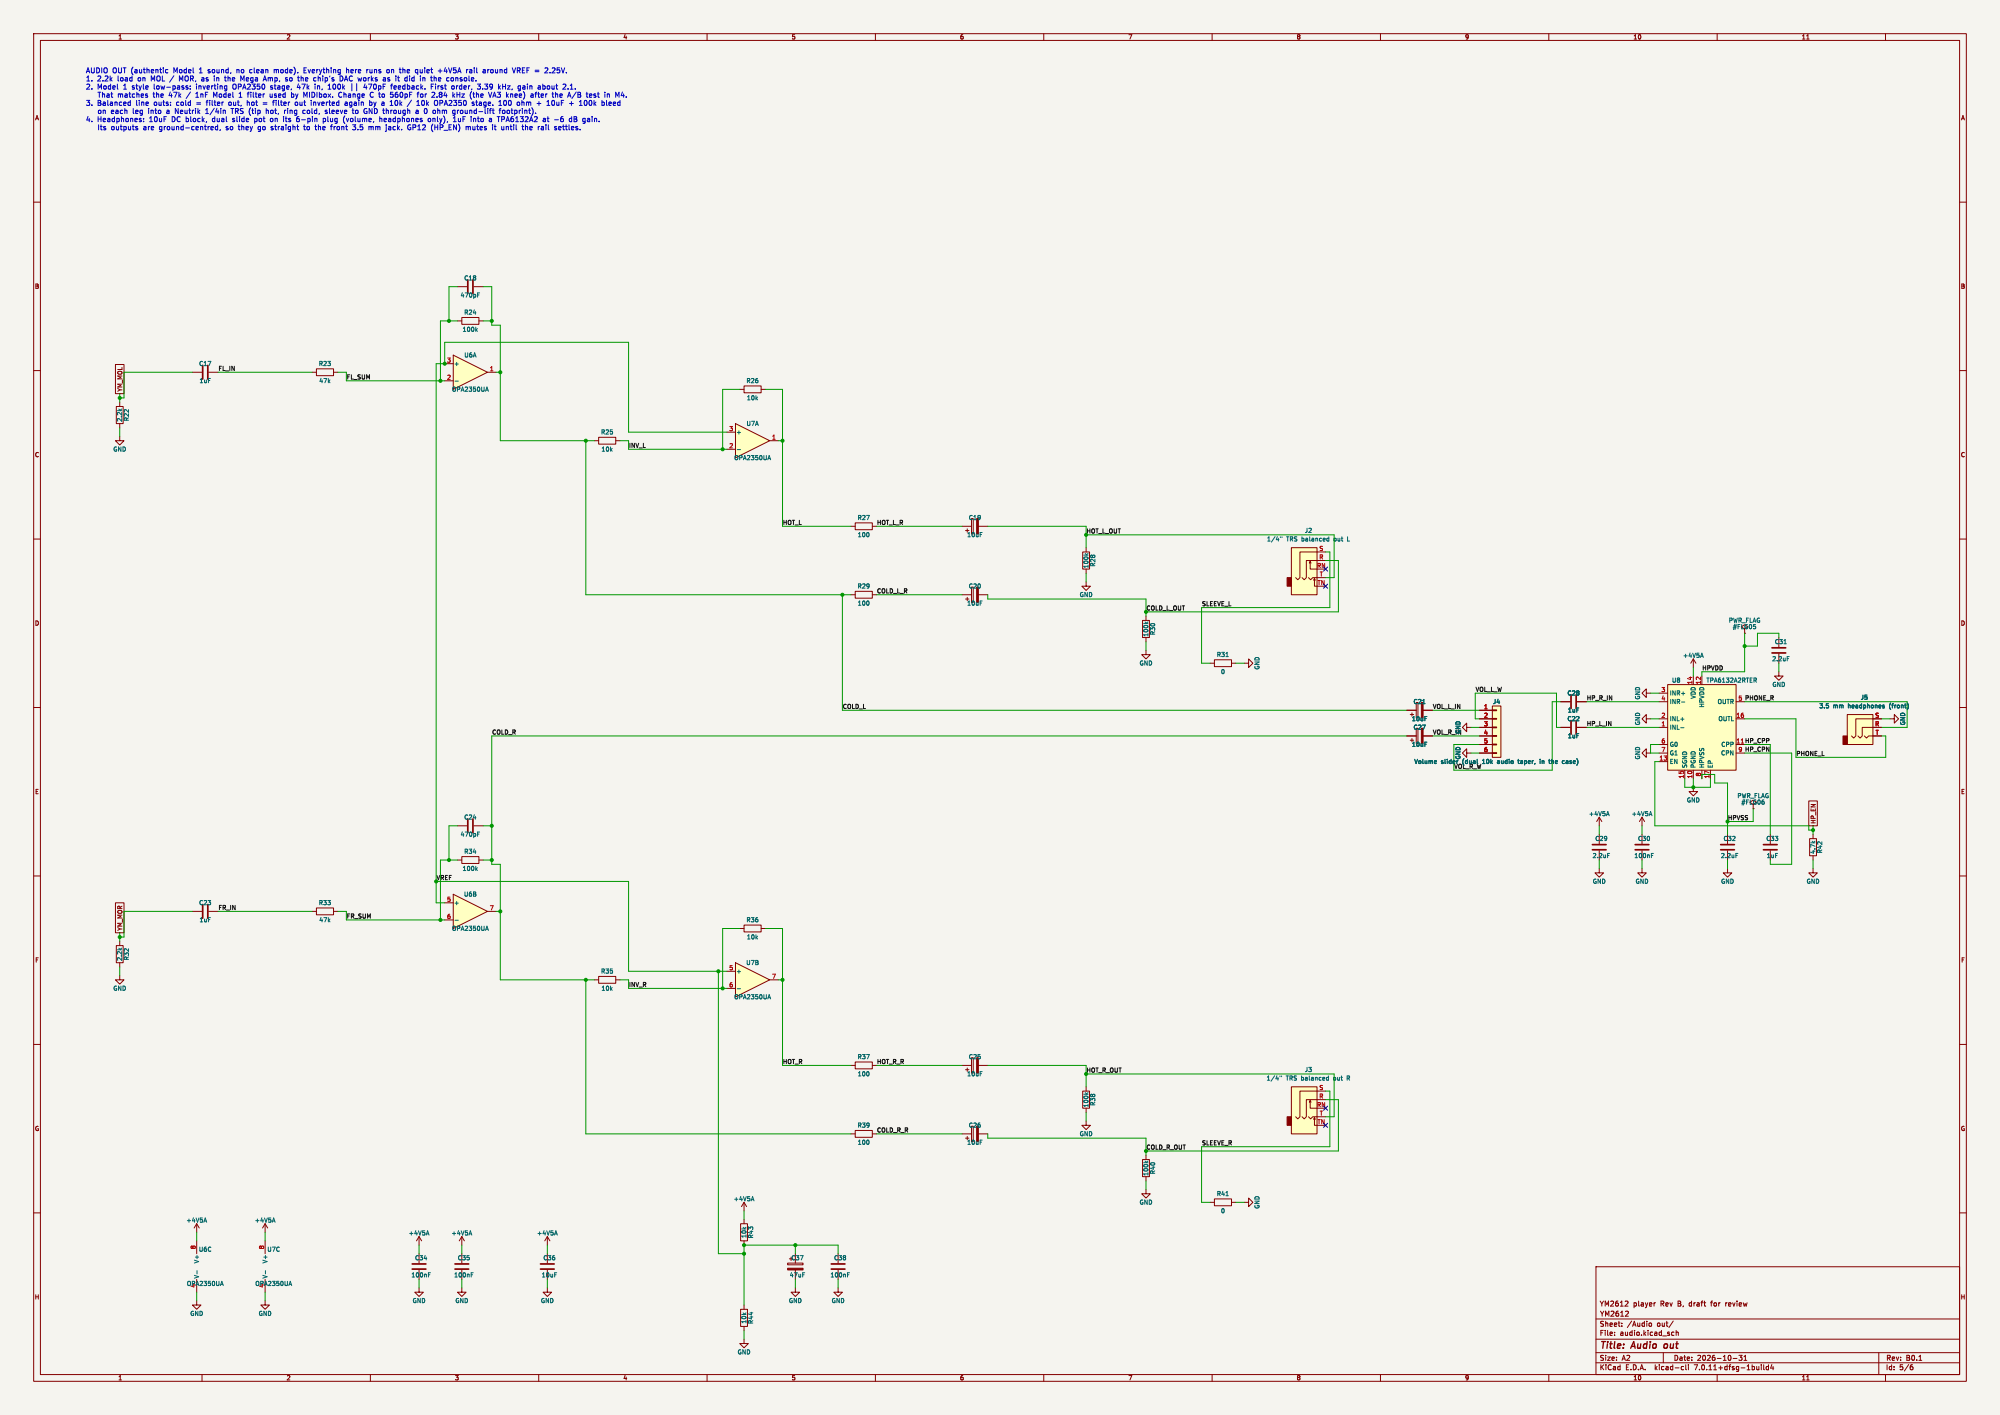
[picture p6: page 5]

J4 Volume slider (dual 10k audio taper, in the case) C21
VOL_L_IN
VOL_R_IN

J4 Volume slider (dual 10k audio taper, in the case) 1

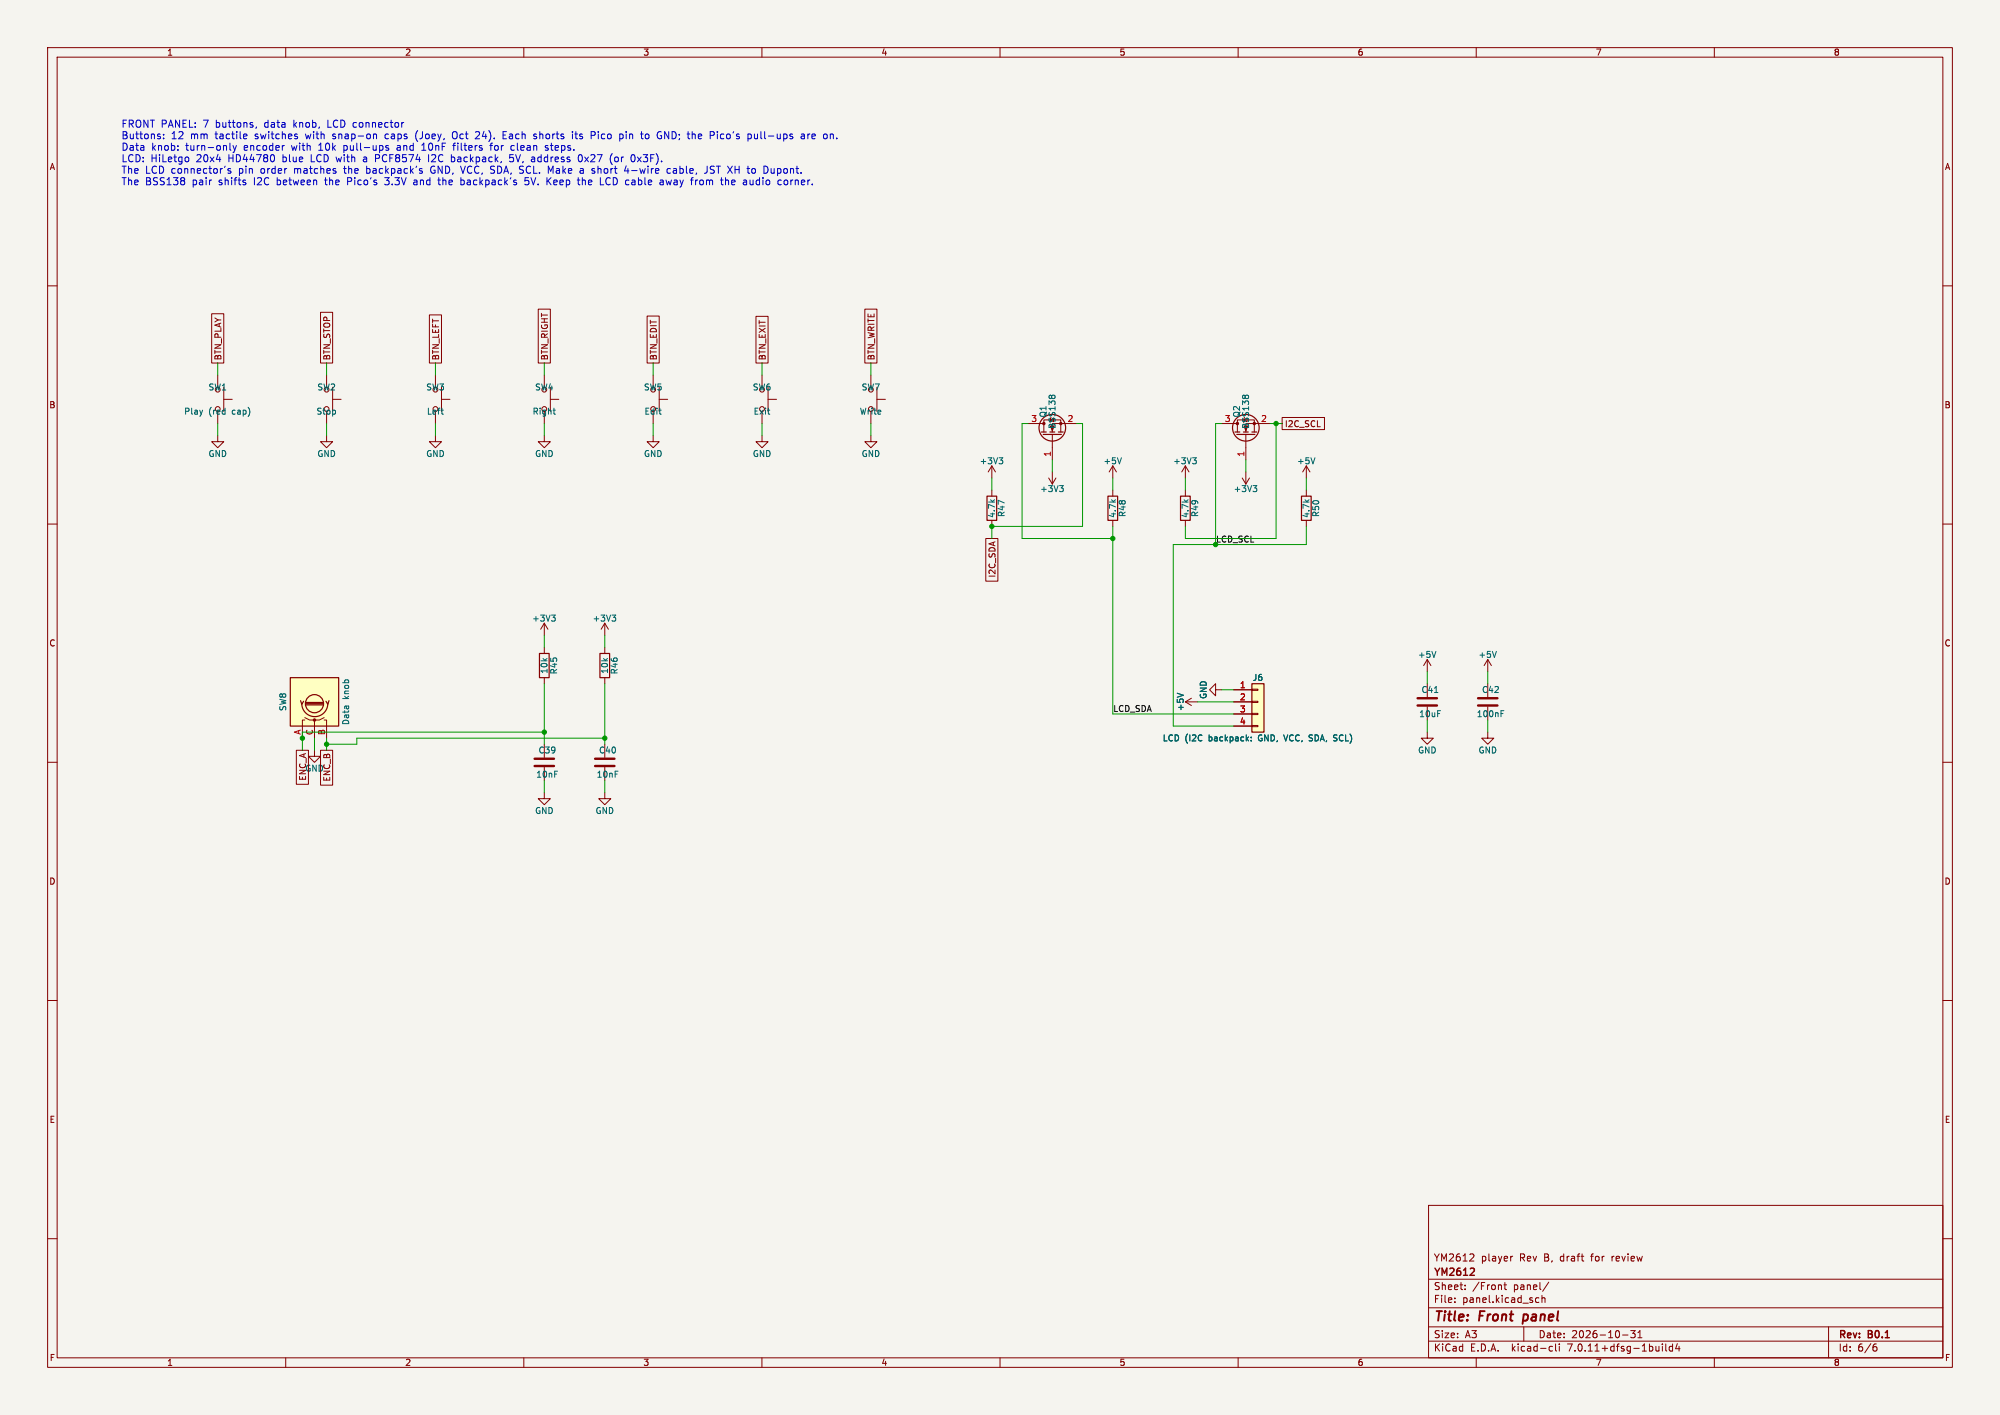
[picture p7: page 6]
