ctrlvlts-000/Vintage-Sound-Chip-Player/hardware/ym2612_player/ym2612_player.kicad_pcb

## KiCad design hardware/ym2612_player/ym2612_player.kicad_pcb (2026-10-31)

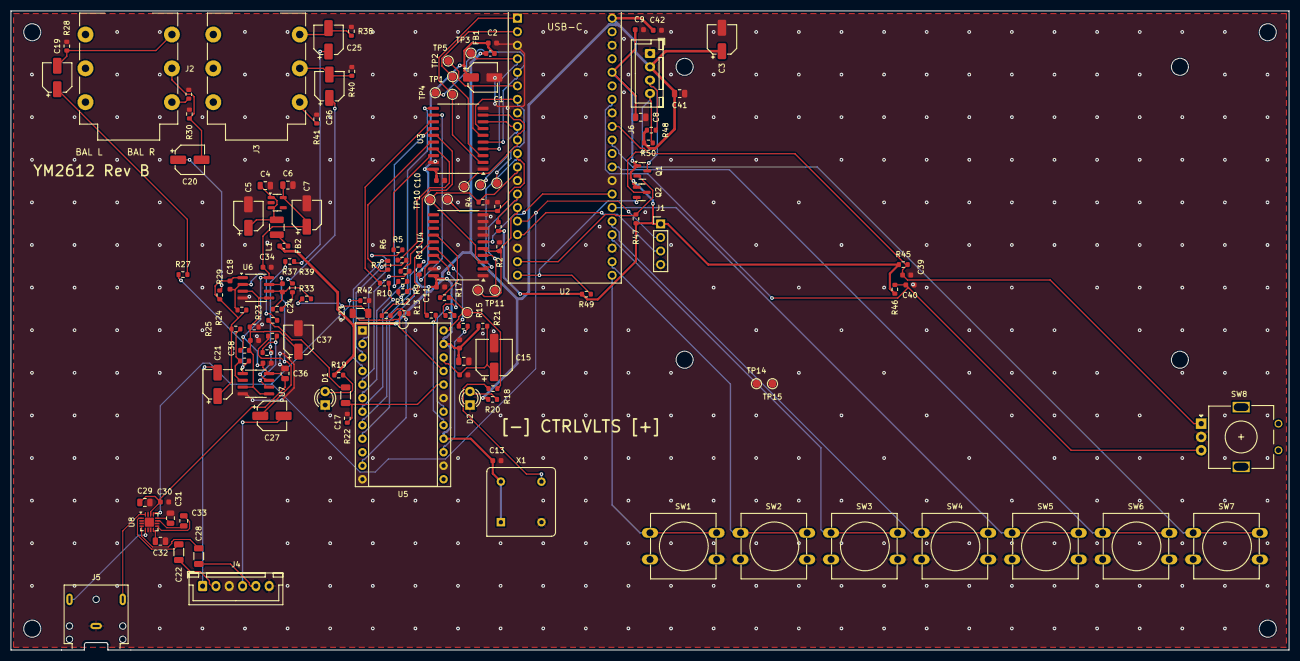
[picture p8: board ym2612_player.kicad_pcb from above]

Board: 2 copper layers, 240.0 x 120.0 mm, 145 parts (0 on the bottom side), 100 nets.

Parts:
C1, C3, C5, C7, C37: 47uF; CP_Elec_5x5.4
C2, C9, C10, C11, C12, C13, C16, C30, C34, C35, C38, C42: 100nF; C_0603_1608Metric
C4: 22uF; C_0805_2012Metric
C6: 4.7uF; C_0805_2012Metric
C8, C14, C36, C41: 10uF; C_0805_2012Metric
C15: 220uF; CP_Elec_6.3x7.7
C17, C22, C23, C28: 1uF; C_1206_3216Metric
C18, C24: 470pF; C_0603_1608Metric
C19, C20, C21, C25, C26, C27: 10uF; CP_Elec_5x5.4
C29, C31, C32: 2.2uF; C_0805_2012Metric
C33: 1uF; C_0805_2012Metric
C39, C40: 10nF; C_0603_1608Metric
D1, D2: warm white 3 mm; LED_D3.0mm
FB1, FB2: 220R@100MHz; L_0603_1608Metric
H1, H2, H3, H4: M3; MountingHole_3.2mm_M3
H5, H6, H7, H8: M3 (LCD); MountingHole_3.2mm_M3
J1: Spare GPIO (not fitted); PinHeader_1x04_P2.54mm_Vertical
J2: 1/4" TRS balanced out L; Jack_6.35mm_Neutrik_NMJ6HCD2_Horizontal
J3: 1/4" TRS balanced out R; Jack_6.35mm_Neutrik_NMJ6HCD2_Horizontal
J4: Volume slider (dual 10k audio taper, in the case); JST_XH_B6B-XH-A_1x06_P2.50mm_Vertical
J5: 3.5 mm headphones (front); Jack_3.5mm_CUI_SJ1-3523N_Horizontal
J6: LCD (I2C backpack: GND, VCC, SDA, SCL); JST_XH_B4B-XH-A_1x04_P2.50mm_Vertical
L1: 10uH; L_1210_3225Metric
Q1, Q2: BSS138; SOT-23
R1, R25, R26, R35, R36, R43, R44, R45, R46: 10k; R_0603_1608Metric
R2, R3, R4, R42, R47, R48, R49, R50: 4.7k; R_0603_1608Metric
R5, R6, R7, R8, R9, R10, R11, R12, R13, R14, R15, R16, R27, R29, R37, R39: 100; R_0603_1608Metric
R17, R18: 33; R_0603_1608Metric
R19, R20: 430; R_0603_1608Metric
R21: 10; R_0603_1608Metric
R22, R32: 2.2k; R_0603_1608Metric
R23, R33: 47k; R_0603_1608Metric
R24, R28, R30, R34, R38, R40: 100k; R_0603_1608Metric
R31, R41: 0; R_0603_1608Metric
SW1: Play (red cap); SW_PUSH-12mm
SW2: Stop; SW_PUSH-12mm
SW3: Left; SW_PUSH-12mm
SW4: Right; SW_PUSH-12mm
SW5: Edit; SW_PUSH-12mm
SW6: Exit; SW_PUSH-12mm
SW7: Write; SW_PUSH-12mm
SW8: Data knob; RotaryEncoder_Alps_EC11E_Vertical_H20mm
TP1: D0; TestPoint_Pad_D1.5mm
TP2: D1; TestPoint_Pad_D1.5mm
TP3: D2; TestPoint_Pad_D1.5mm
TP4: D3; TestPoint_Pad_D1.5mm
TP5: D4; TestPoint_Pad_D1.5mm
TP6: D5; TestPoint_Pad_D1.5mm
TP7: D6; TestPoint_Pad_D1.5mm
TP8: D7; TestPoint_Pad_D1.5mm
TP9: A0; TestPoint_Pad_D1.5mm
TP10: A1; TestPoint_Pad_D1.5mm
TP11: WR; TestPoint_Pad_D1.5mm
TP12: IC; TestPoint_Pad_D1.5mm
TP13: YM_CLK; TestPoint_Pad_D1.5mm
TP14, TP15: GND; TestPoint_Pad_D1.5mm
U1: LP5907MFX-4.5; SOT-23-5
U2: Pimoroni Pico Plus 2; Pimoroni_PicoPlus2_Socketed
U3, U4: 74HCT541; SOIC-20W_7.5x12.8mm_P1.27mm
U5: YM2612 (socket only, chip fitted by hand); DIP-24_W15.24mm_Socket
U6, U7: OPA2350UA; SOIC-8_3.9x4.9mm_P1.27mm
U8: TPA6132A2RTER; WQFN-16-1EP_3x3mm_P0.5mm_EP1.68x1.68mm
X1: 7.670454 MHz, 5V (not fitted); Oscillator_DIP-8

Connections:
+3V3: C8.1, C9.1, J1.1, Q1.1, Q2.1, R1.1, R45.1, R46.1, R47.1, R49.1, U2.36
+4V5A: C6.1, C7.1, C29.1, C30.1, C34.1, C35.1, C36.1, R43.1, U1.5, U6.8, U7.8, U8.14
+5V: C3.1, C41.1, C42.1, FB1.1, FB2.1, J6.2, R19.1, R20.1, R48.1, R50.1, U2.40
+5V_YM: C1.1, C2.1, C10.1, C11.1, C12.1, C13.1, C14.1, FB1.2, R21.1, U3.20, U4.20, U5.16, U5.23, X1.1, X1.8
BTN_EDIT: SW5.1, U2.26
BTN_EXIT: SW6.1, U2.29
BTN_LEFT: SW3.1, U2.24
BTN_PLAY: SW1.1, U2.21
BTN_RIGHT: SW4.1, U2.25
BTN_STOP: SW2.1, U2.22
BTN_WRITE: SW7.1, U2.31
COLD_L: C18.2, C21.1, R24.2, R25.1, R29.1, U6.1
COLD_L_OUT: C20.2, J2.R, R30.1
COLD_L_R: C20.1, R29.2
COLD_R: C24.2, C27.1, R34.2, R35.1, R39.1, U6.7
COLD_R_OUT: C26.2, J3.R, R40.1
COLD_R_R: C26.1, R39.2
ENC_A: C39.1, R45.2, SW8.A, U2.32
ENC_B: C40.1, R46.2, SW8.B, U2.34
FL_IN: C17.2, R23.1
FL_SUM: C18.1, R23.2, R24.1, U6.2
FR_IN: C23.2, R33.1
FR_SUM: C24.1, R33.2, R34.1, U6.6
GND: C1.2, C2.2, C3.2, C4.2, C5.2, C6.2, C7.2, C8.2, C9.2, C10.2, C11.2, C12.2, C13.2, C14.2, C15.2, C16.2, C29.2, C30.2, C31.2, C32.2, C34.2, C35.2, C36.2, C37.2, C38.2, C39.2, C40.2, C41.2, C42.2, D1.1, D2.1, J1.4, J4.3, J4.6, J5.S, J6.1, R2.2, R3.2, R4.2, R22.2, R28.2, R30.2, R31.2, R32.2, R38.2, R40.2, R41.2, R42.2, R44.2, SW1.2, SW2.2, SW3.2, SW4.2, SW5.2, SW6.2, SW7.2, SW8.C, TP14.1, TP15.1, U1.2, U2.3, U2.8, U2.13, U2.18, U2.23, U2.28, U2.33, U2.38, U3.1, U3.10, U3.19, U4.1, U4.7, U4.8, U4.9, U4.10, U4.19, U5.1, U5.12, U5.14, U5.19, U6.4, U7.4, U8.2, U8.3, U8.6, U8.7, U8.10, U8.15, U8.17, X1.4
HOT_L: R26.2, R27.1, U7.1
HOT_L_OUT: C19.2, J2.T, R28.1
HOT_L_R: C19.1, R27.2
HOT_R: R36.2, R37.1, U7.7
HOT_R_OUT: C25.2, J3.T, R38.1
HOT_R_R: C25.1, R37.2
HPVDD: C31.1, U8.12
HPVSS: C32.1, U8.8
HP_CPN: C33.2, U8.9
HP_CPP: C33.1, U8.11
HP_EN: J1.2, R42.1, U2.16, U8.13
HP_L_IN: C22.2, U8.1
HP_R_IN: C28.2, U8.4
I2C_SCL: Q2.2, R49.2, U2.20
I2C_SDA: Q1.2, R47.2, U2.19
INV_L: R25.2, R26.1, U7.2
INV_R: R35.2, R36.1, U7.6
LCD_SCL: J6.4, Q2.3, R50.2
LCD_SDA: J6.3, Q1.3, R48.2
LED_WIN1: D1.2, R19.2
LED_WIN2: D2.2, R20.2
MCU_A0: R3.1, TP9.1, U2.11, U4.2
MCU_A1: R4.1, TP10.1, U2.12, U4.3
MCU_CLK: U2.27, U4.6
MCU_D0: TP1.1, U2.1, U3.2
MCU_D1: TP2.1, U2.2, U3.3
MCU_D2: TP3.1, U2.4, U3.4
MCU_D3: TP4.1, U2.5, U3.5
MCU_D4: TP5.1, U2.6, U3.6
MCU_D5: TP6.1, U2.7, U3.7
MCU_D6: TP7.1, U2.9, U3.8
MCU_D7: TP8.1, U2.10, U3.9
MCU_IC: R2.1, TP12.1, U2.15, U4.5
MCU_WR: R1.2, TP11.1, U2.14, U4.4
OSC_OUT: R18.1, X1.5
PHONE_L: J5.T, U8.16
PHONE_R: J5.R, U8.5
SLEEVE_L: J2.S, R31.1
SLEEVE_R: J3.S, R41.1
SPARE_GP13: J1.3, U2.17
VA_IN: C4.1, C5.1, L1.2, U1.1, U1.3
VA_RAW: FB2.2, L1.1
VOL_L_IN: C21.2, J4.1
VOL_L_W: C22.1, J4.2
VOL_R_IN: C27.2, J4.4
VOL_R_W: C28.1, J4.5
VREF: C37.1, C38.1, R43.2, R44.1, U6.3, U6.5, U7.3, U7.5
YMB_A0: R13.1, U4.18
YMB_A1: R14.1, U4.17
YMB_CLK: R17.1, U4.14
YMB_D0: R5.1, U3.18
YMB_D1: R6.1, U3.17
YMB_D2: R7.1, U3.16
YMB_D3: R8.1, U3.15
YMB_D4: R9.1, U3.14
YMB_D5: R10.1, U3.13
YMB_D6: R11.1, U3.12
YMB_D7: R12.1, U3.11
YMB_IC: R16.1, U4.15
YMB_WR: R15.1, U4.16
YM_A0: R13.2, U5.17
YM_A1: R14.2, U5.18
YM_AVCC: C15.1, C16.1, R21.2, U5.22
YM_CLK: R17.2, R18.2, TP13.1, U5.24
YM_D0: R5.2, U5.2
YM_D1: R6.2, U5.3
YM_D2: R7.2, U5.4
YM_D3: R8.2, U5.5
YM_D4: R9.2, U5.6
YM_D5: R10.2, U5.7
YM_D6: R11.2, U5.8
YM_D7: R12.2, U5.9
YM_IC: R16.2, U5.11
YM_MOL: C17.1, R22.1, U5.20
YM_MOR: C23.1, R32.1, U5.21
YM_WR: R15.2, U5.15
