ctrlvlts-000/Vintage-Sound-Chip-Player/(commit log)

2026-10-23 Refocus design doc on a YM2612-only proof of concept
    Drops the multi-chip series and swappable modules. Adds the register
    light grid, register controls, YM2612 VGM details, Genesis PSG question,
    and an enclosure section for Joey's 3D-printed case.
    Claude-Session: https://claude.ai/code/session_01Fj66rywpisQHdiV7Fmjfoo
2026-10-23 Switch design to synth controls only
    Replaces direct register editing with 12 center-detent synth knobs,
    channel select, and bypass. Register editing moves to a later expert mode.
    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
2026-10-23 Limit panel to 8 synth knobs
    Drops Detune, merges Decay and Sustain, and moves volume to the encoder.
    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
2026-10-23 Simplify controls to 4 assignable knobs
    Brightness, Feedback, Envelope, and Pitch, each pointed at any channel
    with its own Assign button.
    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
2026-10-23 Model knob control on the TQ5's Easy Edit
    Brilliance, Tone, Envelope (attack + release), and Pitch, each with
    -10..+10 steps around the song's own sound.
    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
2026-10-23 Play YM2612 parts only and use Korg DS-8 style knobs
    Skips Genesis PSG writes. Knobs become Timbre, Timbre EG, Amp EG, and
    Pitch, split by modulators vs. carriers like the DS-8's timbre and
    amplitude sections.
    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
2026-10-24 Rewrite design doc for Rev A: VGM playback only
    Rev A is the simplest, lowest-cost player: microSD VGM import, playback,
    one 3.5 mm headphone/line-out jack, an OLED showing the track, and
    Up/Down/Start/Stop buttons. Lights, synth knobs, fuller transport, and
    enclosure ideas move to docs/LATER-REVISIONS.md.
    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
2026-10-24 Load VGM files over USB-C instead of microSD
    The board's flash appears as a USB drive for drag-and-drop. Switches to
    the Pimoroni Pico Plus 2 for USB-C, 16 MB flash, and PSRAM, and drops
    the microSD socket and its pins.
    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
2026-10-24 Add balanced outputs and a -70 dB noise target
    Two balanced 1/4-inch TRS line outs alongside the headphone jack, a
    filtered low-noise analog rail, grounding rules, and an M4 measurement
    target. Notes how the player appears in Ableton over USB MIDI.
    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
2026-10-24 Fix balanced driver cost
    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
2026-10-24 Add a data knob for Korg-style sound tweaks
    One push-and-turn encoder steps through Channel, Timbre, Timbre EG,
    Amp EG, and Pitch, working in both VGM and MIDI mode. Uses three spare
    GPIOs, so no I/O expander is needed.
    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
2026-10-24 Replace push-knob menu with K3/Poly-61 style edit mode
    An Edit button plus Up/Down select any of 56 numbered parameters from
    a chart printed on the case; the data knob sets the value. Covers every
    YM2612 sound setting, with Korg-style quick controls in row 0.
    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
2026-10-24 Switch to a late-80s synth menu panel with a green OLED
    A 3.12-inch 256x64 SSD1322 OLED styled as a green terminal always shows
    the playing file and the parameter being edited. One data knob plus
    Play, Stop, Prev, Next, Edit, Exit, and Write drive simple menus for
    every function and every YM2612 sound parameter.
    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
2026-10-24 Use a cheap 1.9-inch ST7789 LCD for the green-terminal screen
    Replaces the SSD1322 OLED with a 320x170 IPS TFT (about $5) that draws
    the green terminal in software. Rough board cost drops to $35-45.
    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
2026-10-24 Fold in the Chip Box spec: 20x4 blue LCD, authoring tools, lit window
    Switches the screen to the HiLetgo HD44780 2004A 20x4 blue character
    LCD on I2C with a level shifter. Adds the audience, a lit chip window,
    a section on tools that export YM2612 VGM, why the Pico was chosen,
    and a chip sourcing note. USB-C loading and USB MIDI stay.
    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
2026-10-24 Add the Mega Drive homage chassis and a front volume slider
    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
2026-10-24 Rename the product to YM2612
    Drops the Chip Shrine name from the docs, the USB drive label, and the
    USB MIDI device name.
    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
2026-10-24 Make the output stage authentic Model 1 only
    Copies the first-model console's analog output filter after the
    YM2612's built-in DAC, with no clean mode and no USB audio.
    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
2026-10-24 Mark the design as concept stage
    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
2026-10-24 Add Rev A schematic draft for a PCBWay turnkey board
    Five-page KiCad schematic for the Pico Plus 2 carrier: power, controller,
    YM2612 with 74HCT541 buffers and socket, Model 1 style audio with balanced
    1/4in outs and headphone amp, and the 12 mm button front panel. Includes a
    generated BOM with manufacturer part numbers, a PDF, the custom YM2612 and
    Pico Plus 2 symbols and footprint, and the generator scripts.
    Claude-Session: https://claude.ai/code/session_01JeM5NcWqyQVA3DixJkw6Wg
    [audio.kicad_sch, bom.csv, controller.kicad_sch, panel.kicad_sch, power.kicad_sch, sound_chip.kicad_sch, ym2612_player.kicad_sch]
2026-10-24 Rev A PCB layout and PCBWay files
    Board is 240 x 120 mm, 2 layers, placed by tools/layout.py and routed with
    Freerouting (tools/route.py). DRC in KiCad 10: 0 errors, 0 unconnected,
    matches the schematic. Adds Gerbers, BOM and placement (CPL) files for a
    PCBWay turnkey order, and a top-view picture.
    Also: volume slider moves off the board onto a 6-pin JST XH plug (J4), and
    the Pico Plus 2 footprint now has its pads and outline in the right place.
    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
    [audio.kicad_sch, bom.csv, controller.kicad_sch, panel.kicad_sch, power.kicad_sch, sound_chip.kicad_sch, ym2612_player.kicad_pcb, ym2612_player.kicad_sch]
2026-10-24 Mount the Pico Plus 2 on sockets, pick the window LED, tidy labels
    The Pico Plus 2 has flash, PSRAM and a connector on its underside, so it
    can't be soldered flat. It now plugs into two 1x20 female sockets in the
    standard Pico hole pattern; the BOM gains the sockets and the headers for
    the module. Tracks around it are re-routed. DRC in KiCad 10: 0 errors,
    0 unconnected, matches the schematic.
    Window LEDs: Lumimax LED3WAW (3 mm warm white). New tools/silk.py moves
    part labels clear of pads and each other; values move to the fab layer.
    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
    [bom.csv, controller.kicad_sch, sound_chip.kicad_sch, ym2612_player.kicad_pcb, ym2612_player_bom.csv]
2026-10-25 Apply the Rev A fix register: decoupling, single ground, A.VCC filter, TPA6132A2
    Schematic
    - YM2612 A.VCC (pin 22) gets its own 10 ohm + 220 uF + 100 nF filter.
    - /IC, A0, A1 pull-downs 10k -> 4.7k (RP2350 erratum E9).
    - Headphone amp: NJM4556A replaced by a TPA6132A2 at -6 dB, no output caps,
    enabled by GP12 (HP_EN, 4.7k pull-down) so power-up doesn't pop.
    - 47 uF electrolytic damps the L1/C4 resonance before the LP5907.
    - GNDA merged into GND; NT1 removed. Four M3 holes for the LCD standoffs.
    - Ferrite label 220R@100MHz to match BLM18PG221SN1D; C15/C22 spec X7R 50V;
    LED lead note for PCBWay.
    - Pico Plus 2 and its headers marked do-not-fit (Joey supplies them);
    sockets are Sullins PPT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
    [audio.kicad_sch, bom.csv, controller.kicad_sch, panel.kicad_sch, power.kicad_sch, sound_chip.kicad_sch, ym2612_player.kicad_pcb, ym2612_player.kicad_sch]
2026-10-31 Rev B layout: wider clearances, no ground traces, 45 degree corners, clean silkscreen
    Same circuit and part positions as Rev A, re-routed after the Oct 30 peer review:
    - 0.25 mm tracks and gaps, 0.7/0.3 mm vias; 0.2 mm only between U8's own QFN pins
    - GND left to the planes; ground vias, stitching and island ties instead of traces
    - 90 degree track corners cut into 45 degree bends
    - 1.0 mm silkscreen labels clear of pads, parts and edges; outlines trimmed off pads
    - DRC (KiCad 7): 0 errors, 0 unconnected, 0 silkscreen warnings; fab files regenerated
    Claude-Session: https://claude.ai/code/session_01TDTDVidYRoyJdUGgsyVTSw
    [ym2612_player.kicad_pcb]
2026-10-31 Schematic: draw real wires between parts instead of name tags
    tools/wires.py routes each page's nets on the 1.27 mm grid around part bodies and text.
    Power pins keep power symbols (neighbouring pins share one), signals that leave a page get
    one global label, and the netlist check still matches design.py exactly (0 mismatches).
    Sound chip and audio pages re-laid out so the wiring reads left to right; title blocks say Rev B.
    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
    [audio.kicad_sch, controller.kicad_sch, panel.kicad_sch, power.kicad_sch, sound_chip.kicad_sch, ym2612_player.kicad_sch]
2026-10-31 Schematic: PWR_FLAG on YM_AVCC (KiCad 10 ERC: A.VCC is fed through R21)
    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
    [audio.kicad_sch, controller.kicad_sch, panel.kicad_sch, power.kicad_sch, sound_chip.kicad_sch, ym2612_player.kicad_sch]
2026-10-31 Silkscreen: add the CTRLVLTS logo above the button row
    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
    [ym2612_player.kicad_pcb]
2026-10-31 Schematic: R13-R18 pin 1 back on the same net as on the board
    The wired redraw drew R13-R17 upright and R18 turned, and swapped which net went to pin 1.
    A resistor doesn't care, but KiCad's board-vs-schematic check flags it. Turn the symbols
    instead, so every pin matches the board's pads again (checked pad by pad: 0 differences).
    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
    [sound_chip.kicad_sch]
2026-11-01 Add independent Rev B review and ngspice simulations
    Review report (findings ranked by severity), the exported netlist and the
    ngspice files for the audio path, supply filters and power-on behaviour.
    No design changes.
    Claude-Session: https://claude.ai/code/session_01TDTDViYwqvbdKE9zoxSbiR
